kelevrablondie/3DPrinting_CADs_visual-ps5-slab/HANDOFF.md

# Handoff: where the last session stopped (2026-11-10)

Read `CLAUDE.md` first, then `CHANGELOG.md`, then this. Sections below "State before that" are history: the
wrap-around design settled their questions (ends, level edges, disc access). Keep them for the reasoning only.

## Latest (2026-11-10): clip strips built, fit tests ready
- **Built:** the south face lip covers the core to x −17.8 (40 mm face stripe, slot through the lip, hidden guide, square
  corners). It replaces the black filler. Slide-in clip strips (proposal below, approved by Mike) are in `cad/wrap.py`,
  and `cad/check_clip_strips.py` passes for all 9 strips.
- **Ready to print first:** `deliverables/fit_tests/` (two coupons + strip-in-offcut), order in `TODO.md`.
- **Decided, not built:** sleeve (plates overhang both ends by the slide distance), see `CLAUDE.md` Removal / sleeve row. Needs Job 1C.
- **Open from the proposal:** hooks rebuilt as parametric solids (item 4), fewer longer strips, the latch's flex arm,
  a chamfer under the strip's dovetail shoulder (it needs supports now). One end stop sits ~2 mm from the z 164 seam (target ≥3).
  The floor grille still skips holes by the old shelf bboxes (`SHELVES`), not the rails.
- **Next:** stepped seam, sleeve, port cut-outs, then the printable set.

### Clip strips: proposal shown to Mike (approved 2026-11-10; items 1–3 and 6 built)
1. Dovetail channel on the plate's inner floor (part of the tile).
2. Solid end stop on the side that takes the pull when the plate slides off, so removal load goes into plastic, not the latch.
3. Thumb latch at the open end: a flex tab snaps over a ledge; press it and slide the strip out, no tools.
4. Hooks rebuilt as clean parametric solids from our cross-sections (`analysis/section*.py`), same 18 positions; fewer, longer strips where hooks line up (Claude's call).
5. ASA, printed upright, layers along the hook shafts; the tab bends across layers (Claude's call).
6. Fit gate: coupons plus one strip in a channel on a plate offcut, test-locked before any full plate.
Open risk: the stock plate flexes when you lift a corner, ours is a stiff tray. If the latches won't release with a slide alone, the release moves into the strip.

## State before that (2026-11-02)
Still mid-design on the plate edges, west/east ends and disc access. **Nothing is approved to build yet**: Mike must approve a written description first. Branch `handoff-end-panels` was merged into `main` and deleted.

## Decided 2026-11-02 (recorded in `CLAUDE.md`)
1. **Ends: option D.** Mike likes the BoxPlates look: no separate mesh panels; vent slots in the plates' own end walls, wrapping the corners from the fan grille. Merge his ideas with our design for **FDM / DIY**, not injection moulding: our own pattern (not his line pattern), printable without supports in the face-down tile orientation, ASA wall thickness.
2. **Clips: slide-in, replaceable strips** in channels on the plate, no glue. Replaces glued shelves + 0.8 mm pockets.
3. **Seam: diagonal + stepped**, near z≈158, must clear the clip strips.
4. Heat test: optional, "nice to test afterwards".
5. Duplicate `Ps5 *.stl` downloads deleted (all six matched tracked files byte-for-byte past the header).

## Next questions for Mike (one at a time, brainstorming skill)
1. End wall height/profile: level edge vs following the slanted skirt, and whether the slots run the full end or only near the fan (west).
2. Slot style for FDM: e.g. hex holes continuing the grille vs our own slot pattern.
3. Disc access "swoop" (item 4 below) still unresolved.
4. Clip-strip retention: friction fit, snap detent, or a screw/stop at the channel end.

## What Mike asked for (his words, in order)
1. On the end walls added this session: "not what I had in mind". The sides should be "more consistant with the 'hide' language".
2. "additional pannels, that are slants to the new actual side plates and they are meshed, to prevent blocked airflow".
3. The slants should be "visualy level and not repeat the curve of the core".
4. Disc access: "an integrated cutout" in the actual panel, "almost like the original plate does this... the pannel basically swoops in, having a litlle edge lip". Reference: `sources/reference-images/style_reference_render_10.webp`.
5. Compass directions, console horizontal and facing you, disc drive at the bottom right: upper panel **north**, under panel **south**, mesh panels **west and east** ("where the vertical stand and empty space was on the original").
6. "level edges on the x axis throughout the 'face' of the console and it's back. where it blocks airflow, insert the vents."

## Claude's mapping and findings (not yet confirmed by Mike)
- North = flat plate, south = disc plate, west = fan end (z≈380), east = drive end (z≈0).
- Level edge position is limited by the core's widest point plus the 4 mm reveal, using `slab.py`'s tape values:
  - Face: north x=43.7, south x=-39.3, so 15.5 mm deep.
  - Back: north x=46.2, south x=-41.8, so 13 mm deep.
- These edges are shallower than today's slanted skirts in most places and never deeper, leaving up to 21.5 mm open. So vents on the face and back may not be needed, though airflow is untested. The core's curve stays visible in that open band.
- The drive reaches x≈-50.8, past the level edge, so the swoop must drop to near the south plate over z≈0–165. It is only a rough sketch in the mockup. The drive area isn't clearly visible in render 10, so check the stock plate scan too.
- Plates of 424–434 mm should still fit in two tiles on the 256 mm bed, but this is not checked against the shelves or seam.
- Separate mesh panels need their own mounting. Not discussed yet.

## Conflicts to clear with Mike when the design is written up
These `CLAUDE.md` decisions change if this goes ahead: "Edges" (slanted reveal, core-following skirts) and "Drive" (notch).

## Rejected but still in the code
The semi-open walls are still in `cad/slab.py` (`END_FLAT`, `END_DISC`, `end_wall_cut`, the wall zone in `plate()`), which `wrap.py` imports for its constants. Their scripts and renders moved to `archive/` (2026-11-10).

## How to resume
1. The process in use is the `superpowers:brainstorming` skill. Mike accepted its browser mockups. The questions continue one at a time, and a written description needs his approval before any build.
2. The old mockup server dies with the session. To reopen it, run the skill's `scripts/start-server.sh --project-dir <scratchpad> --open`, then copy `docs/mockups/end_panels_screen.html` into the new `screen_dir`. To change the drawings, edit and run `python3 -I docs/mockups/end_panels_mockup.py <out.html>`.
3. Use cadgen as `cadgen +0.8.4`, the installed version.

## Side items
- Job 1B: the 2026-11-09 research makes 114 the working spacing; only a fan-end confirmation is left. Rear ports (X-ray, Job 1D): notches were drafted and then dropped (2026-11-10). The stripe's disc-side edge moved to −25.5 instead, so plugs clear it; one HDMI reading checks the clearance. (The face side changed again the same day, see Latest.) Job 1C is on hold.
- That model's creator and licence are still unconfirmed, because Cloudflare blocked curl and Mike saved the files rather than the page.

## Video reference: devynPC "BoxPlates" (reviewed 2026-11-02)
Devyn Johnston, "I fixed the PS5 and now YOU can too", https://youtu.be/dNhaeyO8Zh0 (6:03, 31 May 2025). Same maker as the "devynPC-style" shelves. Commercial, injection-moulded flat plates. **No dimensions given.** His prototype was for a PS5 **Pro Digital**, so nothing is fit-verified for our original Disc Edition. Borrow ideas only; his line-pattern look is his design, so don't copy it. Times are transcript times; frame-only observations are approximate.

1. **Seam (open item 2):** his printed prototype is two shells joined by a **diagonal, stepped seam**, not a straight cut, and has hook pads on the floor. It's an option for our z≈158 seam: stiffer and self-aligning.
2. **Clips (4:21–5:01):** separate **slide-in, replaceable** clip strips in PETG (thick walls, dense infill, internal supports) slot into a channel on the plate's inner wall. Ours are glued. Slide-in would remove the glue-and-align step and allow a reprint of one broken clip. This doesn't reopen the "Mounting" decision; ask Mike before changing it.
3. **Airflow (3:01–3:42):** fine parallel slots over the fan carry on down the front lip, **wrap the corners** and run along the sides. This is a possible 4th answer to the west/east end question above: slots cut through the plate's own end walls instead of separate mesh panels, so no extra mounting is needed.
4. **Stock plates block the side intake (3:16–3:30)** and route air round the top and front. Sony's plastic rails round the fan keep the plate off it, so leave clearance over those rails. This supports grilles on both plates.
5. **Thermals (3:44–4:19):** 2 h God of War Ragnarök with stock plates vs 2 h with BoxPlates on a PS5 Pro, filmed with FLIR: same at the centre, cooler overall and at the rear vent. Not rigorous; weak evidence that open sides are safe.
6. **Disc models (2:35–2:39)** need a new bottom plate with a hidden disc slot, which relates to Mike's "swoop" disc access. Not shown in detail.
7. **Geometry (1:47–2:10):** he used a 3D scan, then removed the tilt and straightened the angles; "way more iterations than I expected". Expect several test prints (see Job 1B and the coupons).

## Video reference 2: devynPC "I fixed the PS5 Pro" (reviewed 2026-11-02)
Devyn Johnston, https://youtu.be/yilU2dU2YgA (4:50, 20 Jan 2025). This is the first prototype, made before BoxPlates. The console is a **PS5 Pro** (four plates, two per side), so again nothing is fit-verified for our Disc Edition. **No dimensions, materials or print settings are given.** Times are caption times; frame-only observations are approximate.

1. **Alignment is the main risk (2:49–3:07):** getting each plate's tilt and angle right "took the most trial and error". **1–2 mm off** and the plates collide, clips miss, or the plate visibly isn't level. That supports Job 1B, the coupons, and a cheap partial test print before a full plate.
2. **Check level with a spirit level (~3:20, frame):** he put a spirit level on the printed top plate. Add a spirit-level check to our test fit.
3. **Clips rebuilt as clean CAD (~2:40–2:50, frames):** he aligned the scanned clips, then modelled clean solid clips (ribbed hooks) on top of them instead of using the scan mesh. Our shelves come from scan meshes (`analysis/shelves.py`). When we design the slide-in strips, rebuild the hooks as parametric solids from our clip cross-sections (`analysis/section*.py`).
4. **The first prototype had fixed clips; BoxPlates has slide-in strips.** That's an inference that he moved away from fixed clips, but the video doesn't give a reason.
5. **Vents only where the stock plates left openings (3:24–3:34):** fan grille plus holes on the front and sides. The CAD frames (~3:40) show the hole pattern continuing over the plate's end wall and lip, which is option D. His pattern is an Xbox One S style grid of round holes with a chamfered look, taken from Microsoft's design, so again don't copy it. Our hex grille is our own.
6. **Front lip lowered to hide the curve (0:57–1:03):** the plate lip comes down over the core's curve, leaving the glossy middle strip and its ports open. That matches our "hide" language and the level face and back edges in "What Mike asked for", item 6.
7. **Plate as a shallow tray (~3:30, frame):** a section view shows a floor with low walls and a step partway along. That may be an early version of the stepped seam, but it can't be confirmed from the frame.

## Wrap-around mockup (2026-11-02)
Mike pointed to the 1:05 sketch in video 2: plates as level, constant-height lips with a constant black stripe between them, and the same treatment on the west and east ends. The colour inserts move to the **face**. Drawing: `docs/mockups/wrap_views.png`, made with `python3 -I docs/mockups/wrap_mockup.py <out.png>`.
- Stripe 40 mm, centred on the core (x −17.8…22.2), which is the core's narrowest front width. Each lip comes out at 39.5 mm, so the front reads as thirds. **Superseded 2026-11-10:** stripe x −25.5…22.2 (~48 mm), lips 39.5 / ~32, see `CLAUDE.md` Wrap row.
- Face: vents on both lips at the fan (W) end. The south lip runs level over the drive (z 0…135), and the drive sits behind it with a disc slot hole like the stock faceplate (Mike, 2026-11-02; replaces the swoop). In the core proxy the drive is x −50.8…−17.8, inside the lip, and flush with the core face at y 127.5. The colour inserts sit on the north lip at the E end.
- Back: the lips cover the exhaust, so they are vented end to end. **Port positions are not measured**, and the lips need cut-outs there.
- Ends: both end walls are fully vented (option D), with the same stripe.
- **Depth problem:** a lip that hides the core's curve sits in front of the core face. The core proxy is ±127.5 deep for z 0…200 and tapers to ±121 at the fan end, so the plates grow to about 261 mm deep (0.5 clearance + 2.5 wall per side). That doesn't fit the 256 mm bed in any orientation. **Mike chose separate lip strips** welded to the plate edge (recorded in `CLAUDE.md`). Port positions: TODO.md Job 1D.

## Disc slot, taken from the stock disc-plate scan (2026-11-02)
Measured in `sources/rhys34512-printables-973426/disk-panel.stl` (front-facing surfaces plus sections at z′ 56/96/166), in the console frame:
- **Length:** z′ 22.5…145 (≈122.5 mm, for a 120 mm disc). The drive proxy stops at z 135, so the proxy is about 10 mm short.
- **Width:** 6.0–6.7 mm. It follows the plate's ~2 mm twist, and the straight path common to the whole length is x′ −25.5…−21. The mockup uses x′ −25.5…−20.5.
- **Depth:** the stock slot is not a hole in the face. It's a gap at y′ ≈ 111–113, about 16 mm behind the core face line (127.5), between the end of the plate's angled lower wall and a hollow **box-section edge** (x′ −20…−8) above it.
- **Consequences for the lip strip:** only ~2.7 mm of lip is left between the slot and the stripe edge (−17.8). Copy the stock idea: back that narrow bridge with a box or L section, and guide the disc from the lip slot (y′ ≈ 128–130) back to the drive entry at y′ ≈ 111 with a short tunnel or funnel. The mockup shows only the face opening.

## Back-lip ventilation (2026-11-02)
Mike: the back edges must not obstruct the exhaust, so use bigger openings or a different pattern.
- The back lips cover the core's rear exhaust where the core is wider than the 40 mm stripe: 20 mm per side at the drive end, tapering to 2.5 mm at the fan end. That's about 8,550 of about 23,750 mm², or **~36 % of the rear exhaust face**.
- The round 3.4 mm holes at 5 mm pitch are 42 % open, which leaves **~79 %** of the stock exhaust area overall. A **6 mm hex honeycomb with 1.2 mm webs** is 69 % open, which gives **~89 %**. It's printable: three perimeters at 0.4 mm, holes vertical with the strip face-down. Chosen and drawn in `wrap_views.png`.
- Further lever if the heat test says so: let the back lip stand off the core by a few mm to form a plenum, so air can spread to the open stripe. The lip strips aren't limited by bed depth. Not drawn.
- These are area estimates, not a flow test. Airflow is unverified until the optional heat test.

**Update:** Mike chose the honeycomb for every vent, fan grilles included (2026-11-02). The 2D mockup `wrap_views.png` is final at this stage, and the next step is a 3D draft.

## 3D draft (2026-11-02)
`cad/wrap.py` → `wrap_horizontal` (386 × 261 × 131 mm, 29 parts, ~50 s cold build). Its parts: floor trays with a honeycomb grille, separate face, back and end lip strips (honeycomb vents, the disc slot in the south face lip, colour inserts on the north face lip), TPU feet, the core and drive proxies, and the old shelves relabelled `clip_placeholder_*` (since 2026-11-10: real clip strips and a disc guide). Not drawn: stepped seam, port cut-outs.
**Open question for Mike, orientation:** the model comes from the real-plate scans, and the disc slot confirms +Y is the front. Seen from the front with the console lying disc-side down, it puts the **drive end on the left**. Mike described the drive at the bottom **right**, and `wrap_views.png` follows his description. **Resolved (Mike): trust the model.** From the front, the drive end (E) is on the left and the fan end (W) on the right. `wrap_views.png` is flipped to match. `Superpowers Brainstorming.html` is deleted (deprecated). In the viewer, 0.4 mm engravings show only in **solid** display mode (edges); shaded hides them.

## North top treatment (2026-11-02, built in `wrap.py`)
Mike's answers: hidden seam yes; hide the fan grille but keep the honeycomb; generic technical markings named **MONOLITH**; no colour inlay; single grey. Reference: the Xbox One X Cyberpunk 2077 controller (split line, bracketed mono text). Details are in the CLAUDE.md row "North top". Clip footprints in `wrap.py` `SHELVES` are bboxes copied from the shelf STLs (a `shortcut:` comment). Regenerate them once the slide-in strips exist, and re-check the seam window: z 155…170 north, ≤158 disc middle.
