kelevrablondie/3DPrinting_CADs_visual-ps5-slab/analysis/adapter_concept.png

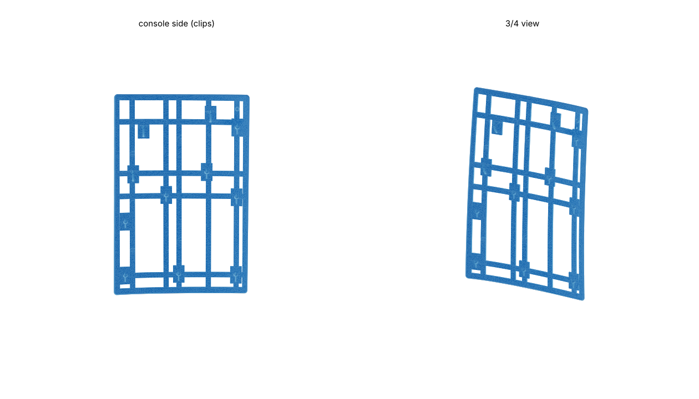
analysis/adapter_concept.png
