kelevrablondie/3DPrinting_CADs_visual-ps5-slab/analysis/clip_map.png

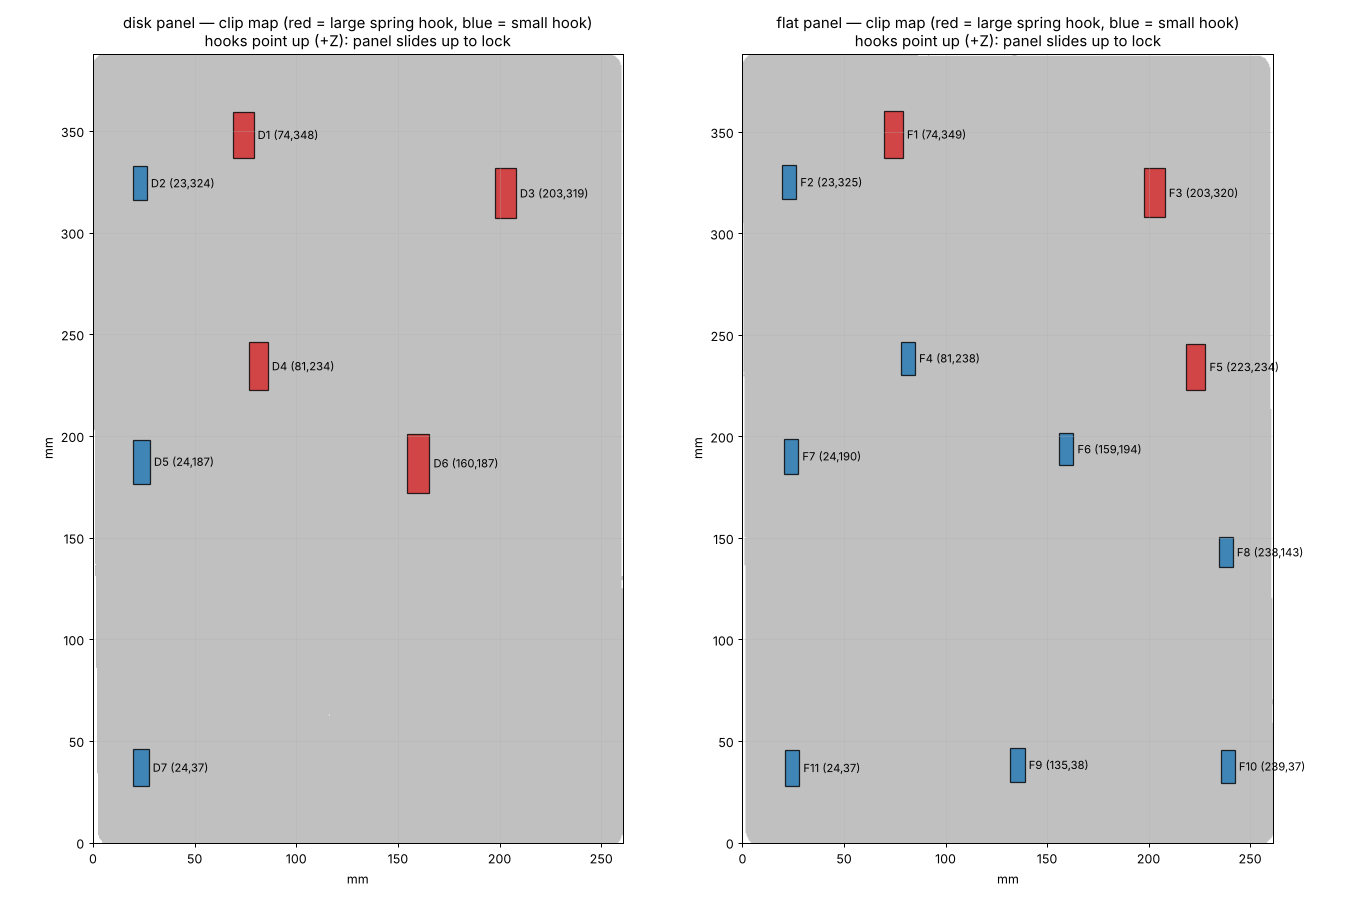
analysis/clip_map.png
