kelevrablondie/3DPrinting_CADs_visual-ps5-slab/analysis/clip_sections.png

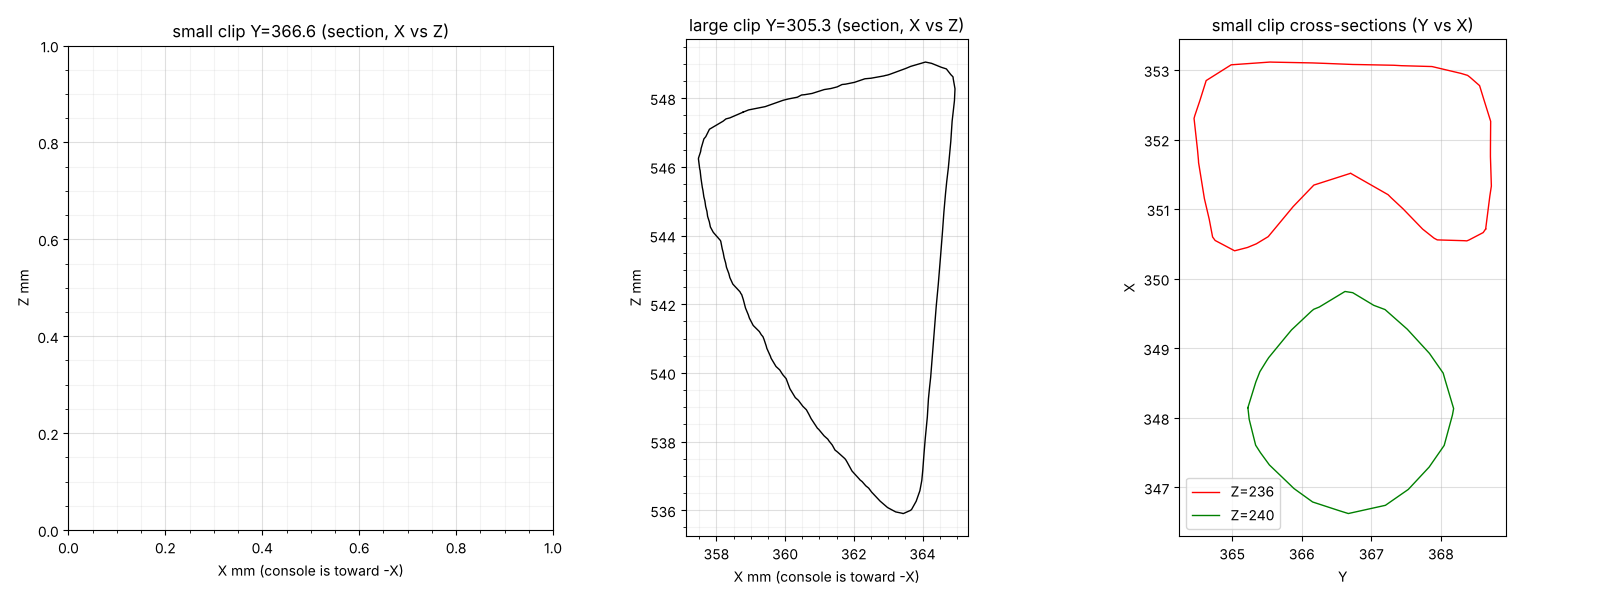
analysis/clip_sections.png
