kelevrablondie/3DPrinting_CADs_visual-ps5-slab/analysis/coupons.png

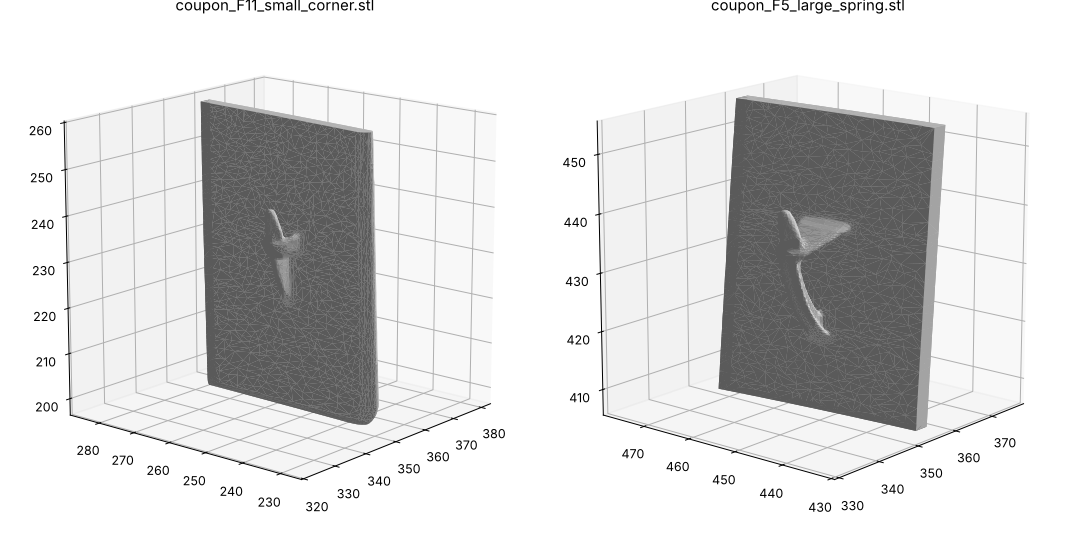
analysis/coupons.png
