kelevrablondie/3DPrinting_CADs_visual-ps5-slab/analysis/disk_inner.png

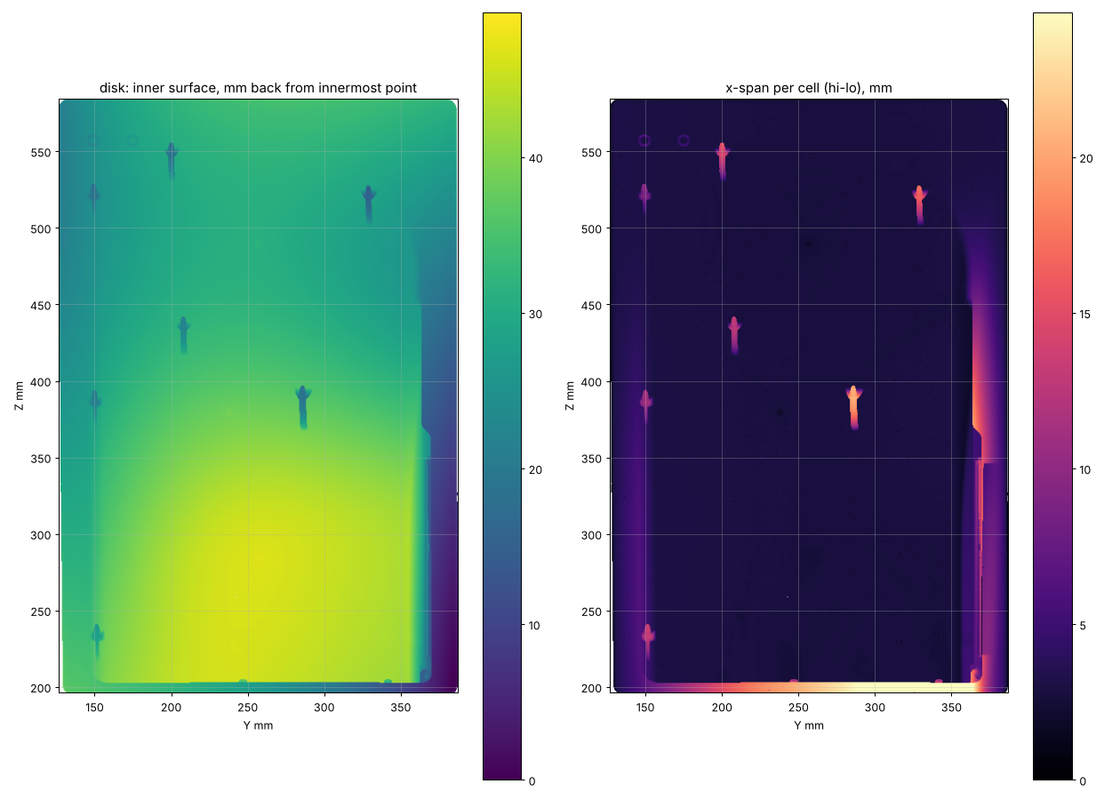
analysis/disk_inner.png
