kelevrablondie/3DPrinting_CADs_visual-ps5-slab/analysis/disk_sec.png

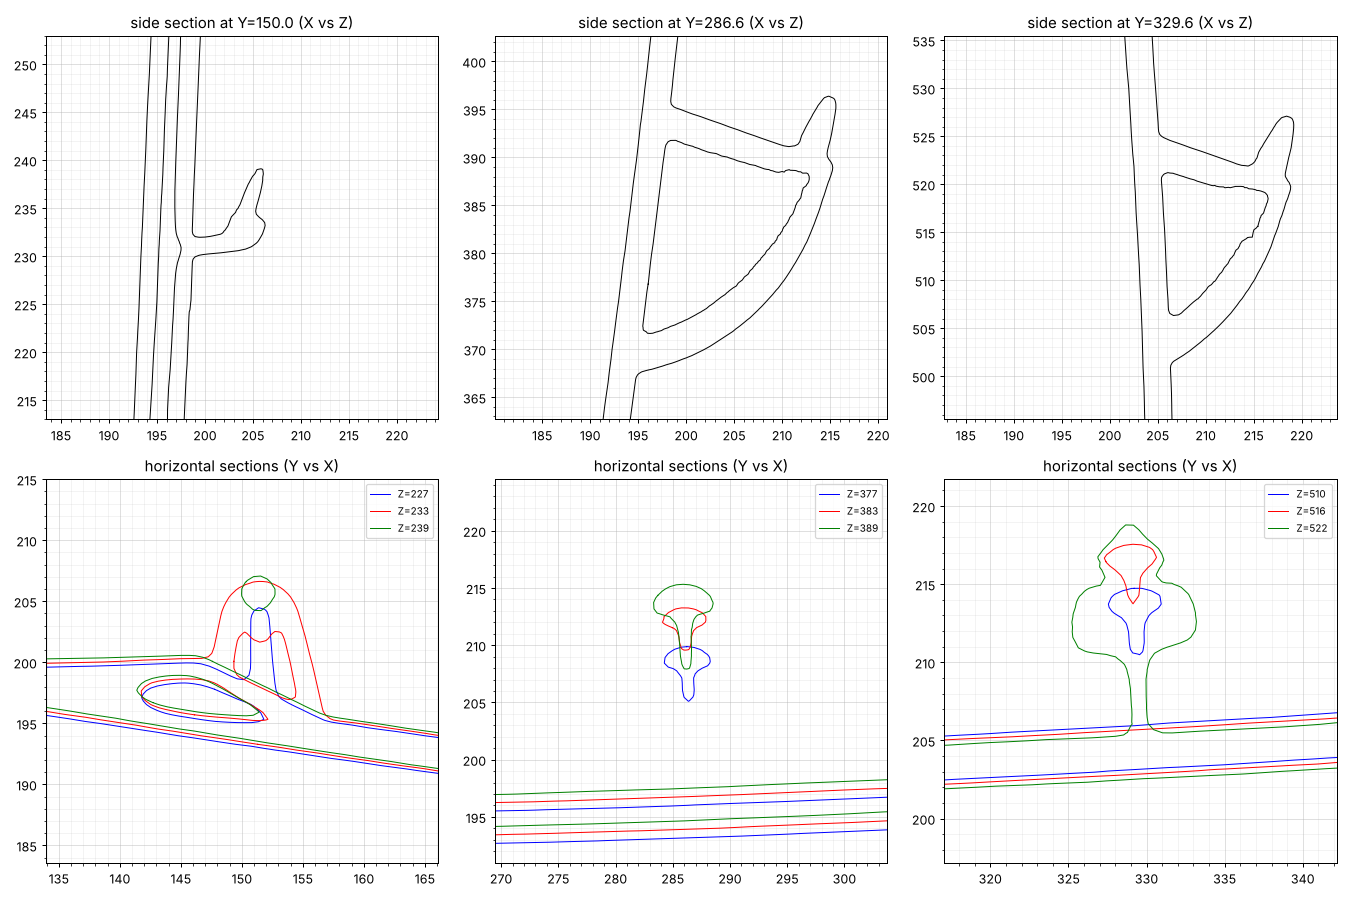
analysis/disk_sec.png
