kelevrablondie/3DPrinting_CADs_visual-ps5-slab/analysis/edge_depth.png

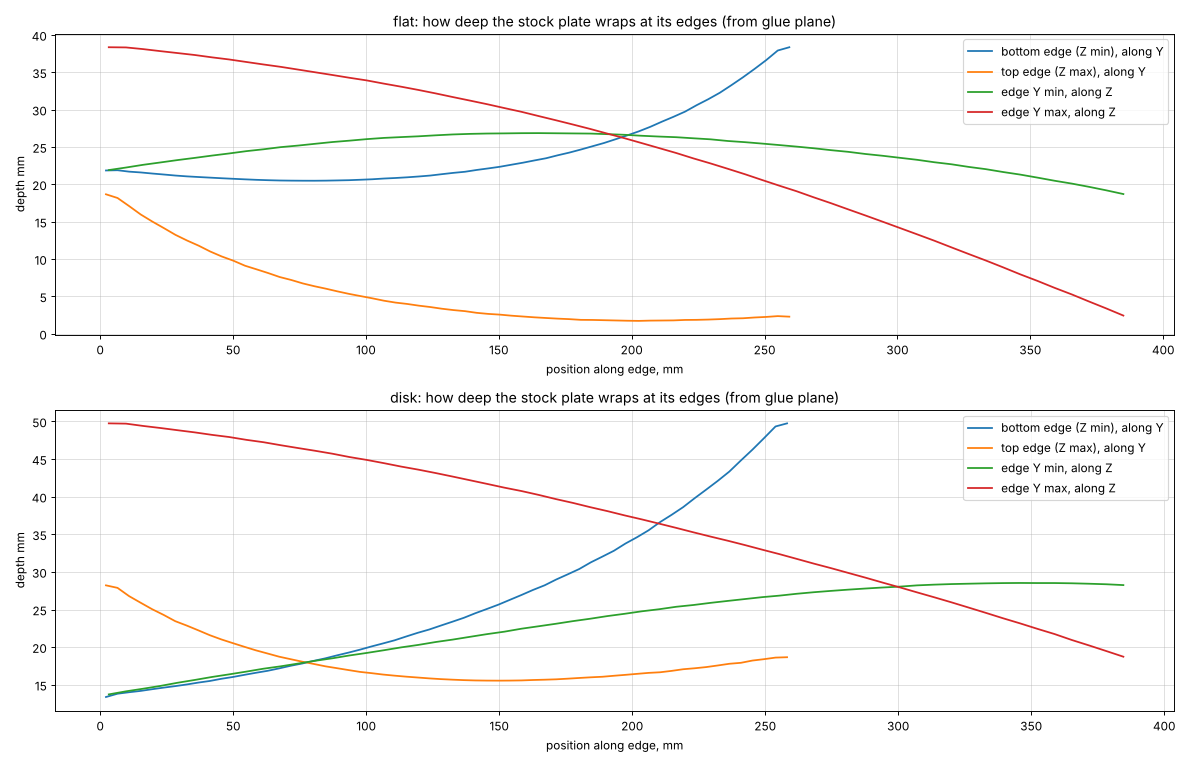
analysis/edge_depth.png
