kelevrablondie/3DPrinting_CADs_visual-ps5-slab/analysis/flat_inner.png

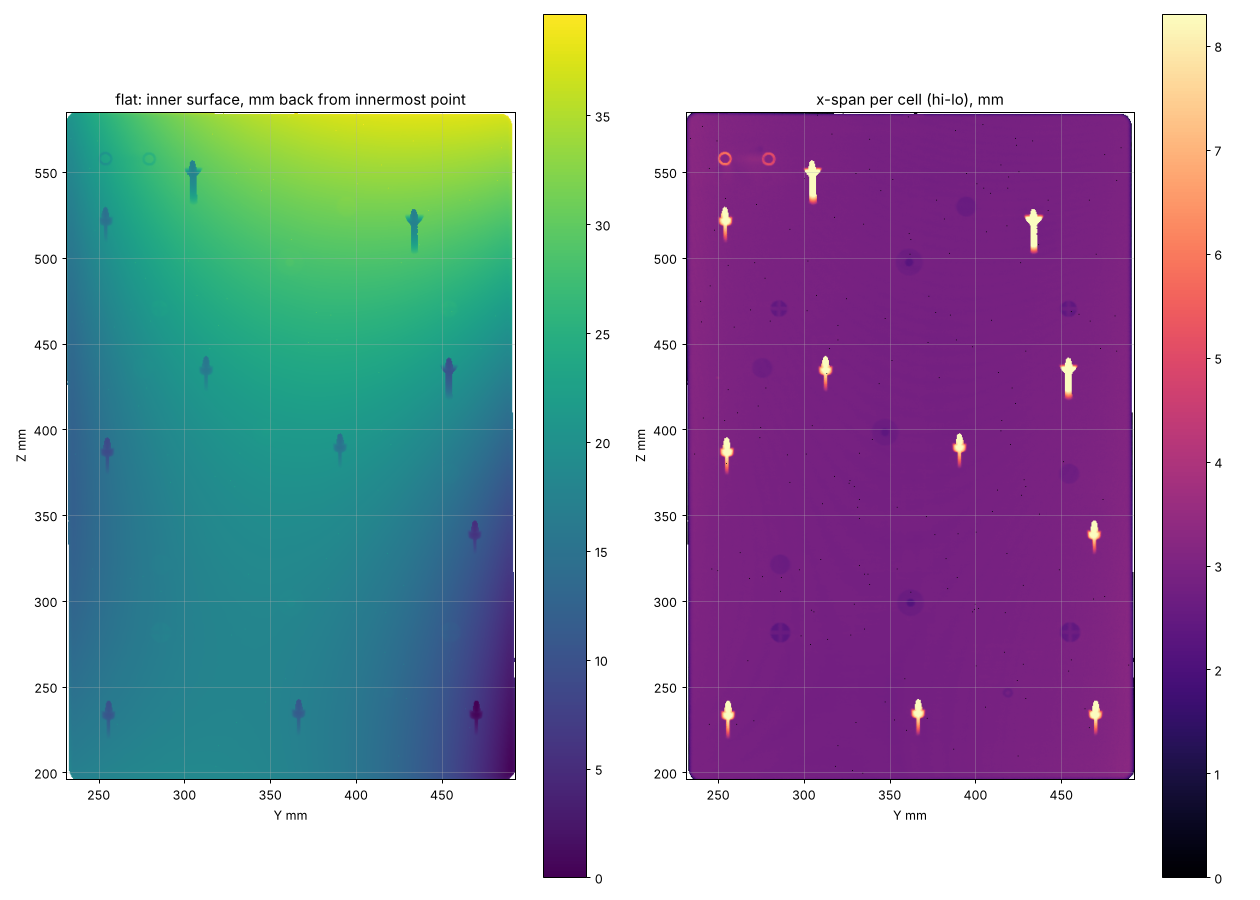
analysis/flat_inner.png
