kelevrablondie/3DPrinting_CADs_visual-ps5-slab/analysis/flat_sec.png

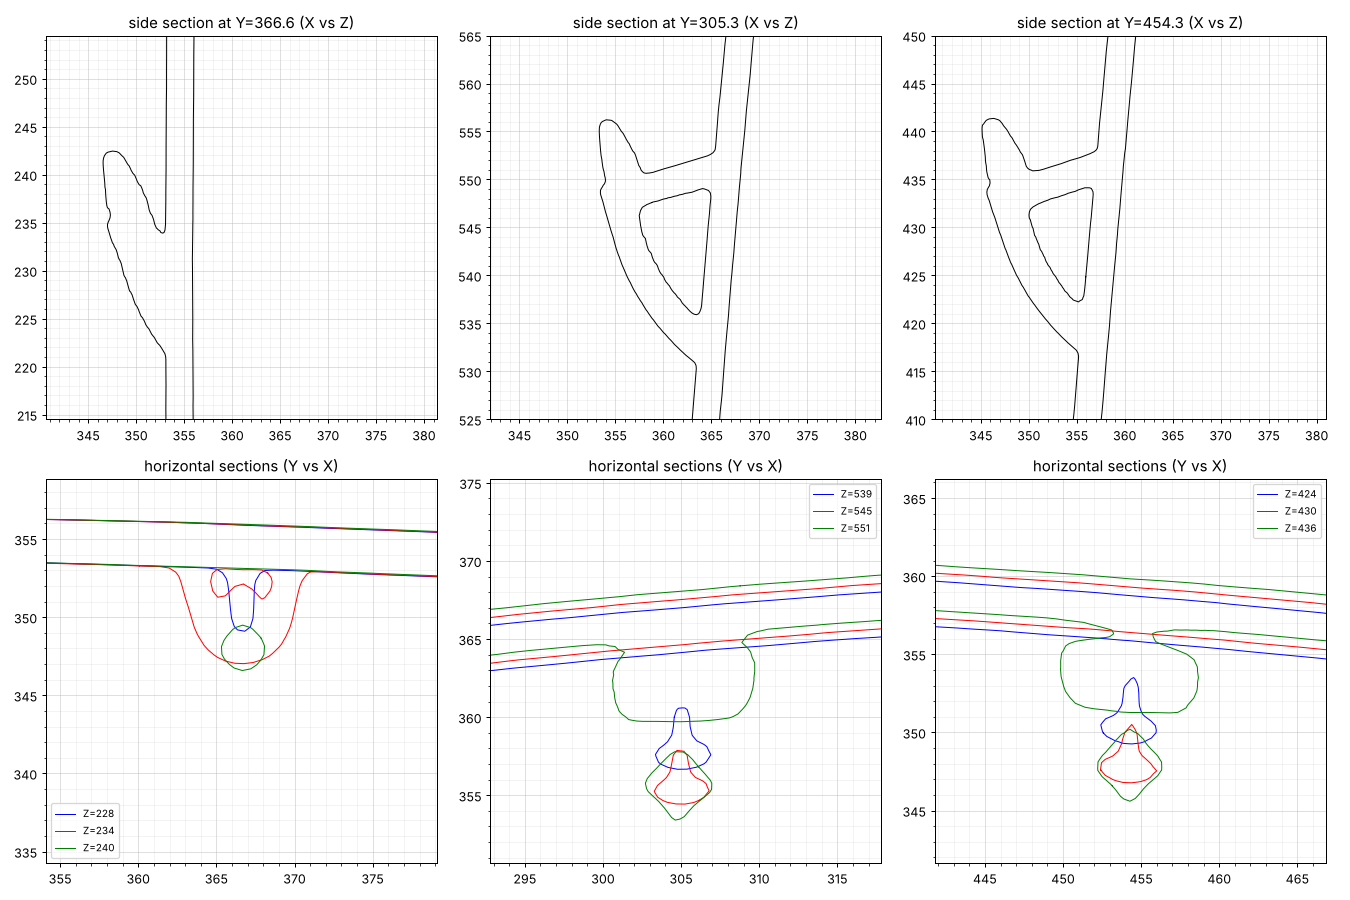
analysis/flat_sec.png
