kelevrablondie/3DPrinting_CADs_visual-ps5-slab/analysis/obj_sections.png

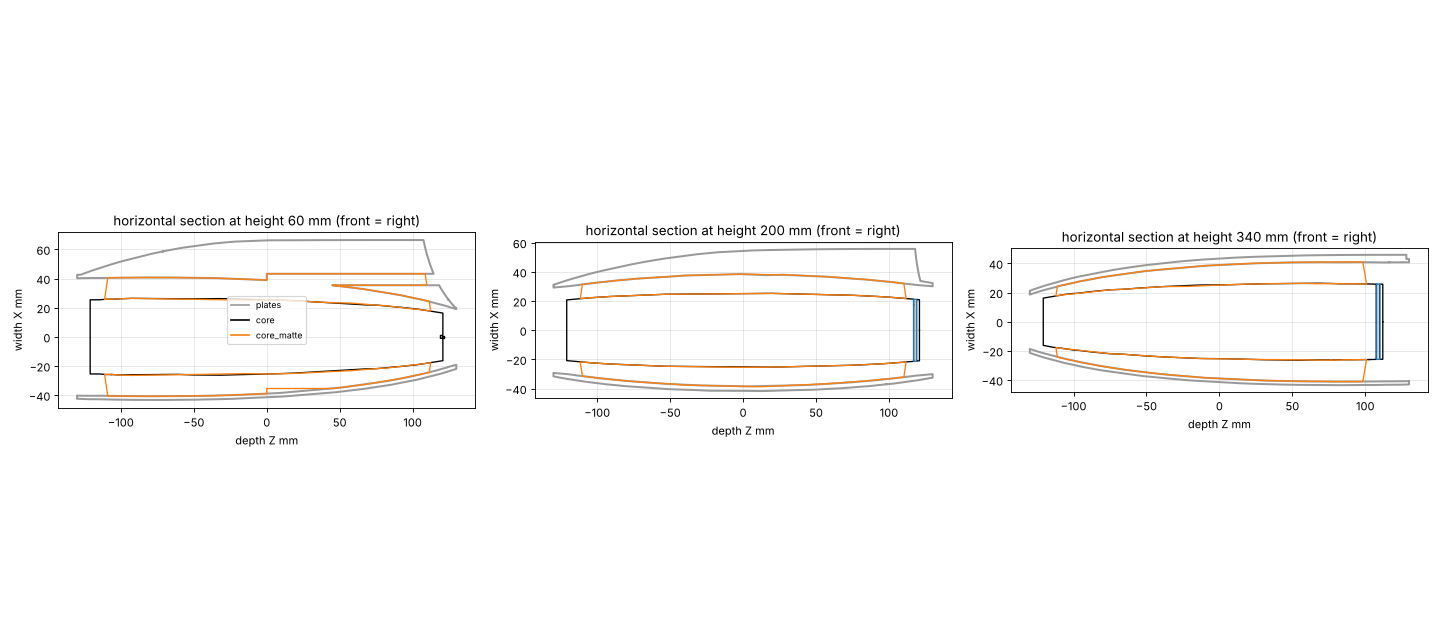
analysis/obj_sections.png
