kelevrablondie/3DPrinting_CADs_visual-ps5-slab/analysis/panel_shape.png

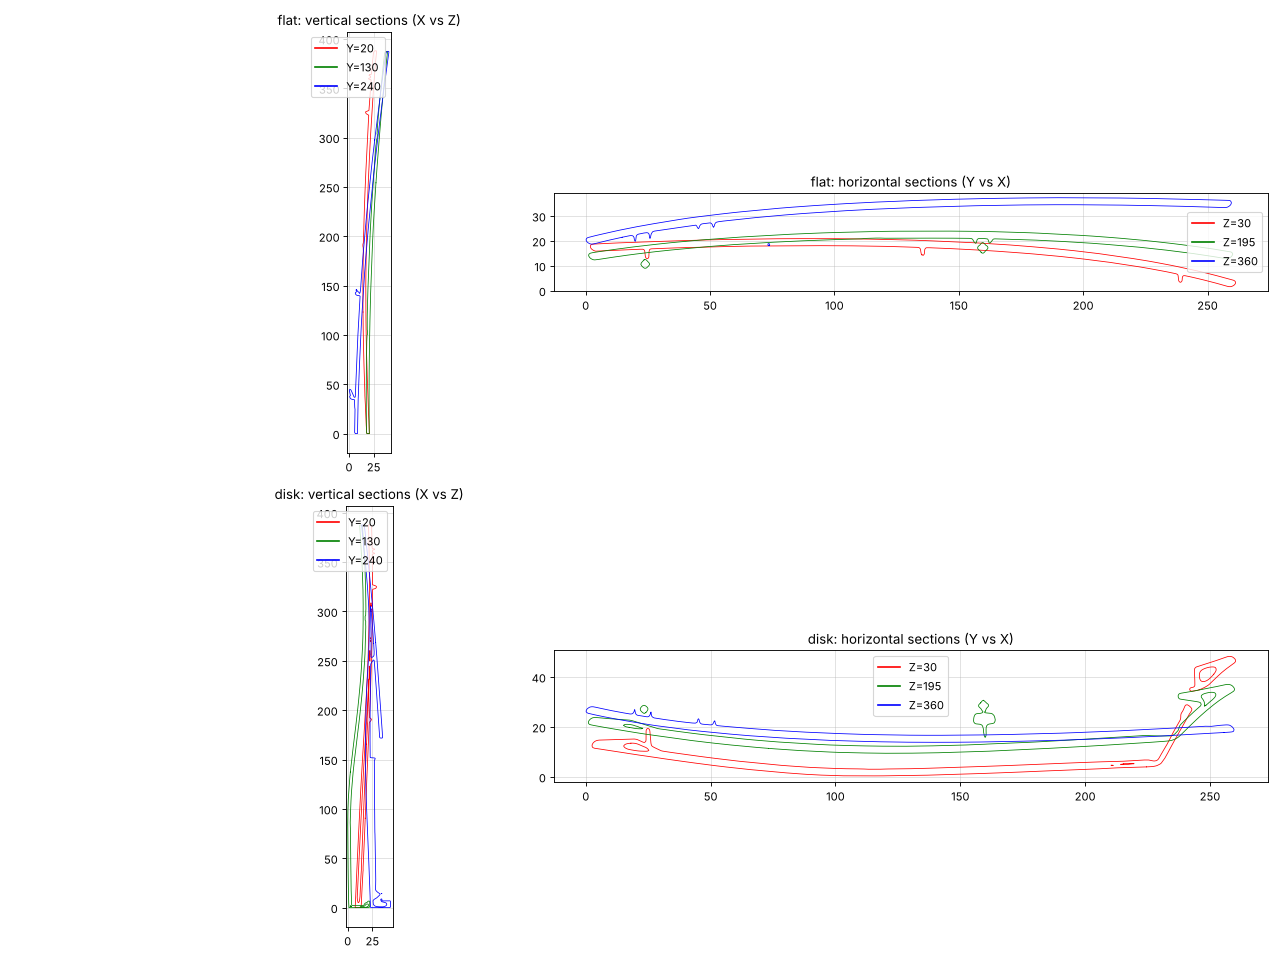
analysis/panel_shape.png
