kelevrablondie/3DPrinting_CADs_visual-ps5-slab/analysis/shelf_detail.png

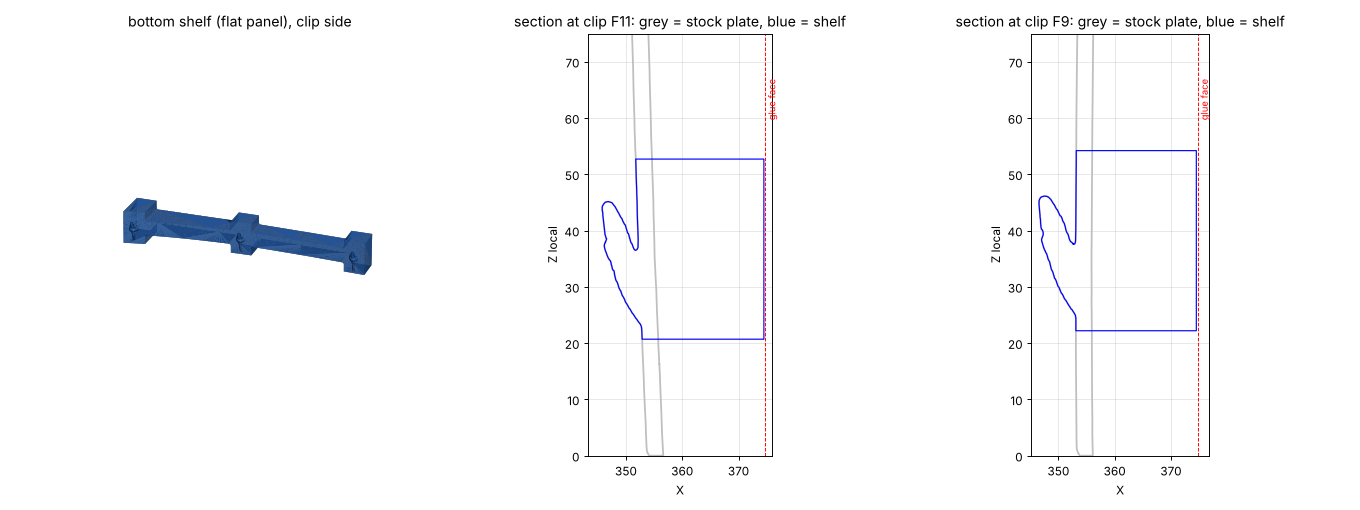
analysis/shelf_detail.png
