kelevrablondie/3DPrinting_CADs_visual-ps5-slab/analysis/shelves_overview.png

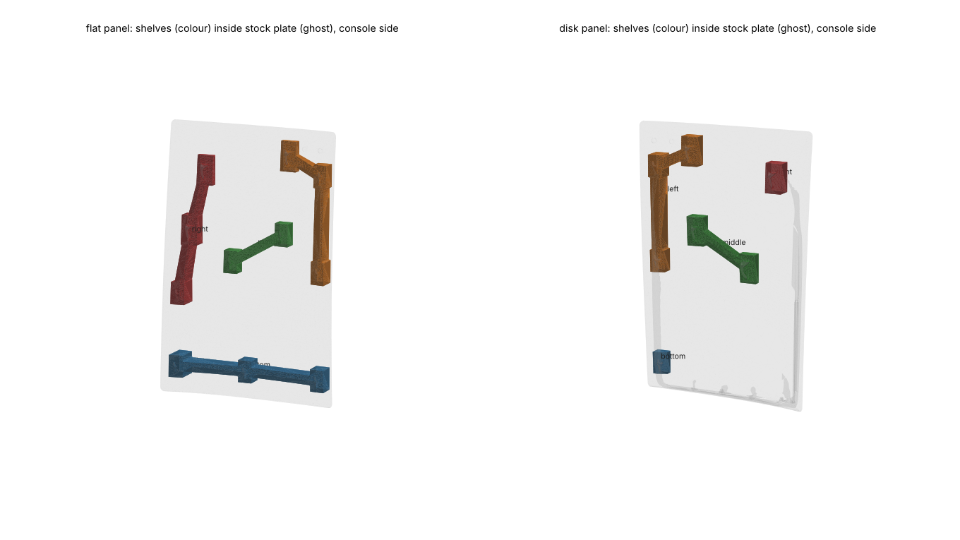
analysis/shelves_overview.png
