kelevrablondie/3DPrinting_CADs_visual-ps5-slab/cad/concept_a.png

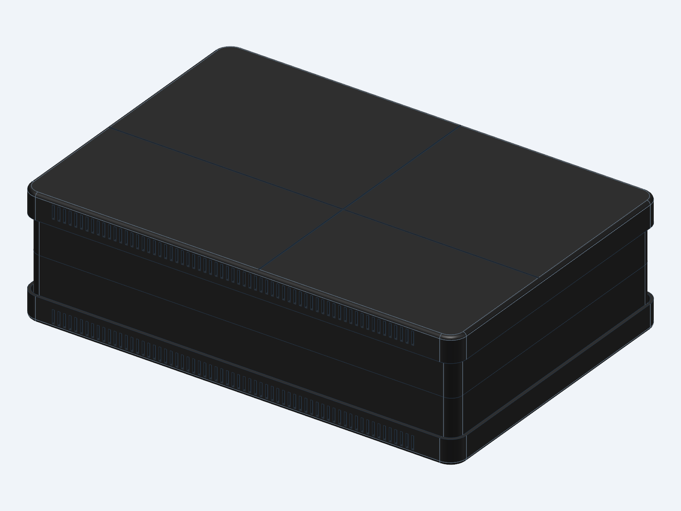
cad/concept_a.png
