kelevrablondie/3DPrinting_CADs_visual-ps5-slab/cad/concept_c.png

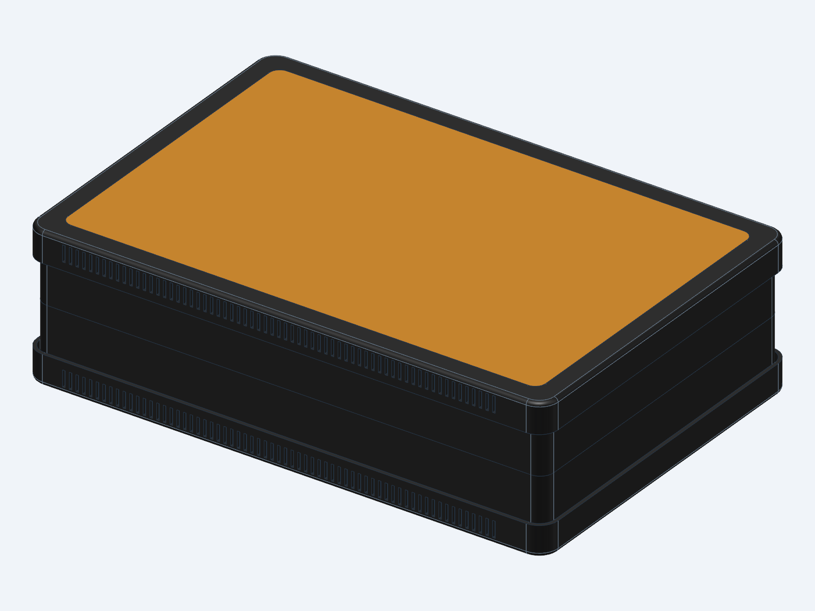
cad/concept_c.png
