kelevrablondie/3DPrinting_CADs_visual-ps5-slab/cad/concept_d_front.png

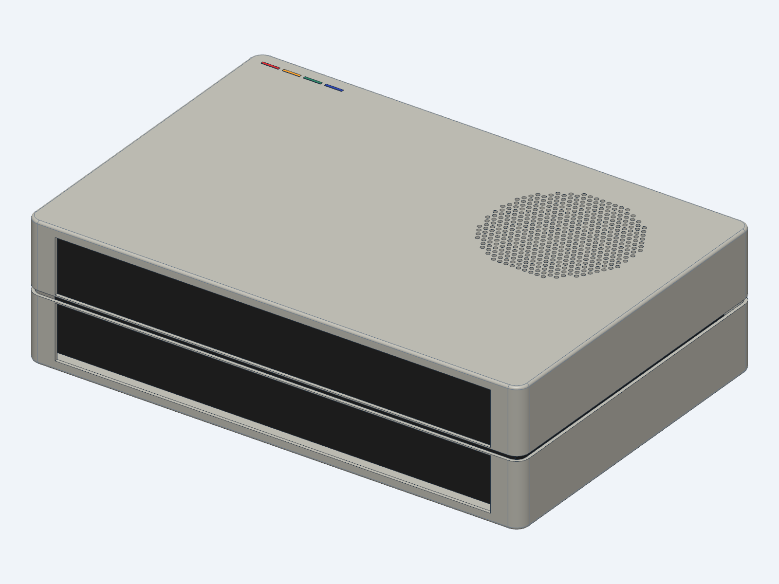
cad/concept_d_front.png
