kelevrablondie/3DPrinting_CADs_visual-ps5-slab/cad/concept_d_rear.png

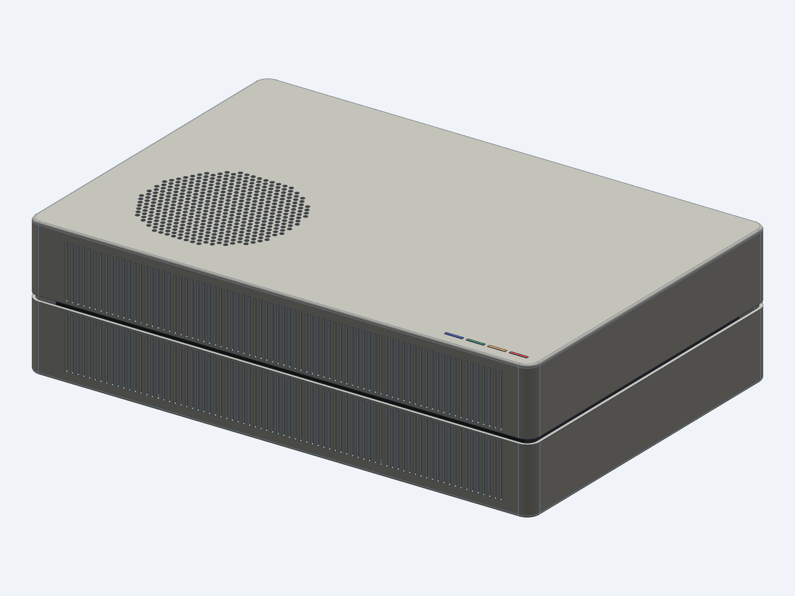
cad/concept_d_rear.png
