kelevrablondie/3DPrinting_CADs_visual-ps5-slab/cad/e_30_20.png

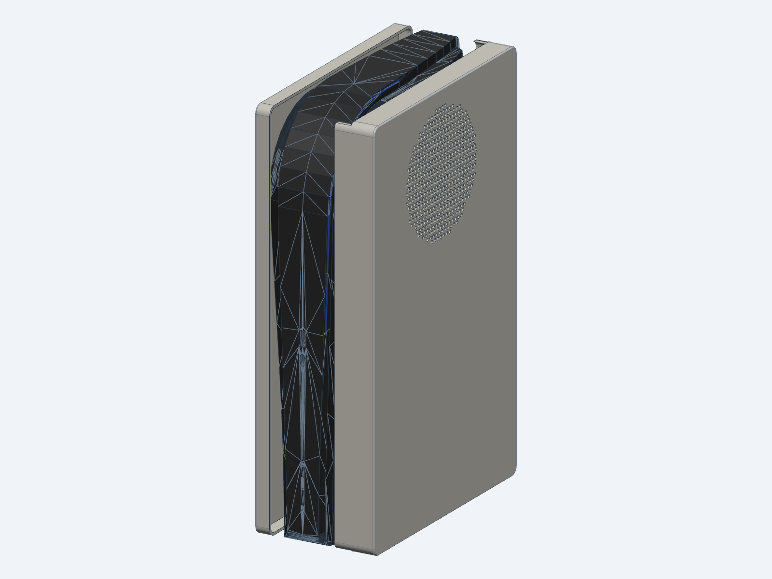
cad/e_30_20.png
