kelevrablondie/3DPrinting_CADs_visual-ps5-slab/cad/e_120_20.png

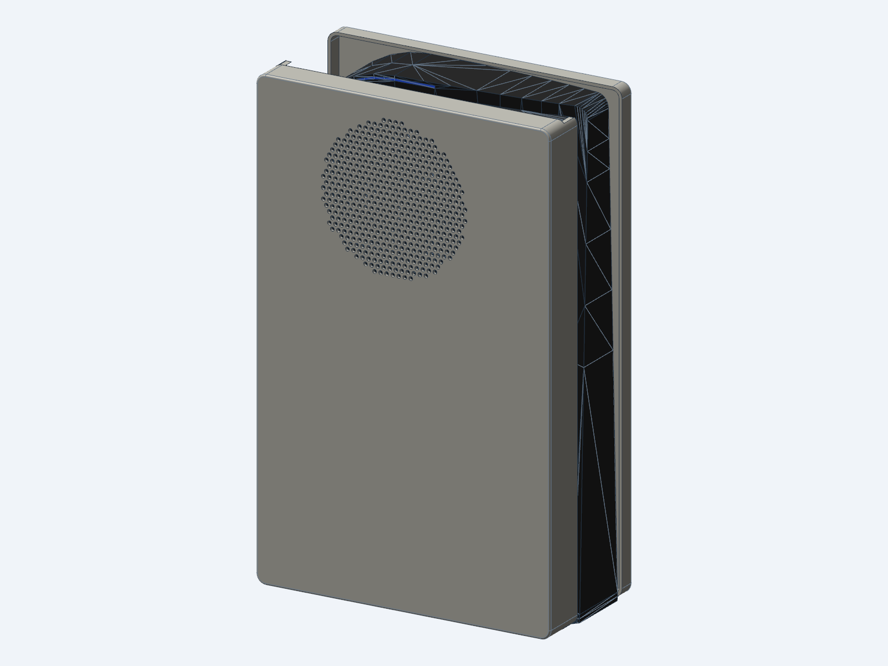
cad/e_120_20.png
