kelevrablondie/3DPrinting_CADs_visual-ps5-slab/cad/e_lie_200_25.png

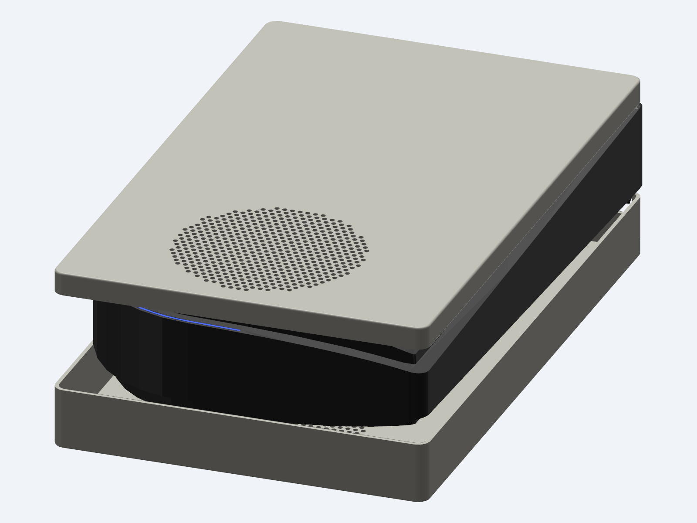
cad/e_lie_200_25.png
