kelevrablondie/3DPrinting_CADs_visual-ps5-slab/cad/e_stand_frontortho.png

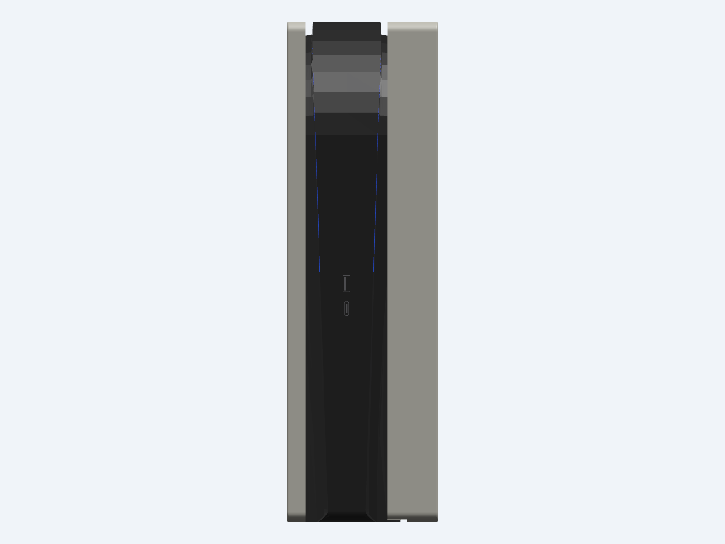
cad/e_stand_frontortho.png
