kelevrablondie/3DPrinting_CADs_visual-ps5-slab/cad/renders/contact.png

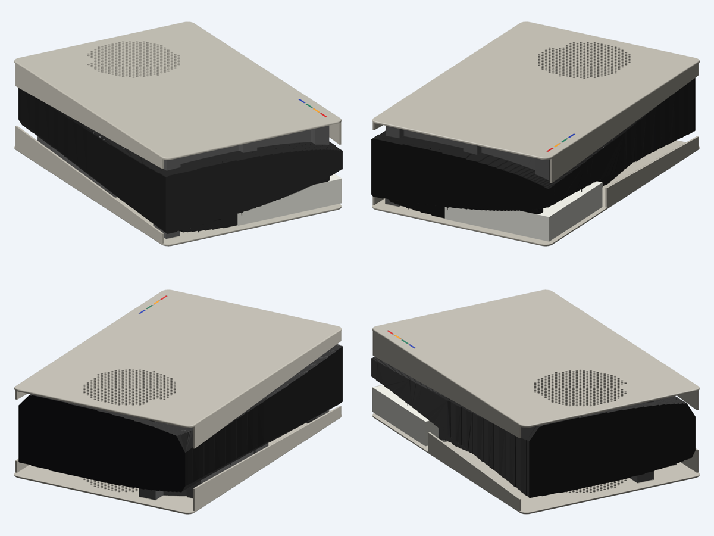
cad/renders/contact.png
