kelevrablondie/3DPrinting_CADs_visual-ps5-slab/cad/renders/ends_left.png

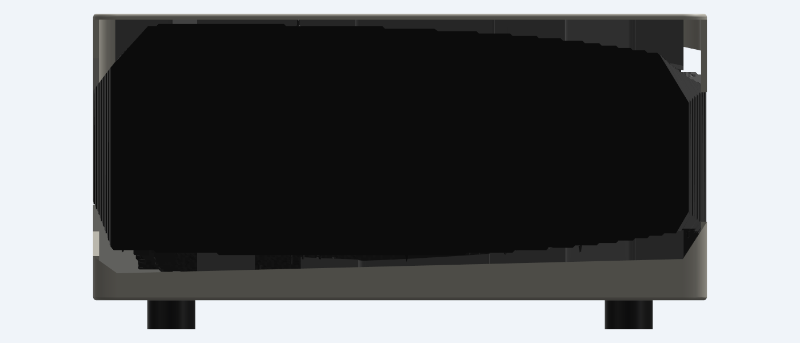
cad/renders/ends_left.png
