kelevrablondie/3DPrinting_CADs_visual-ps5-slab/cad/renders/h_120_22.png

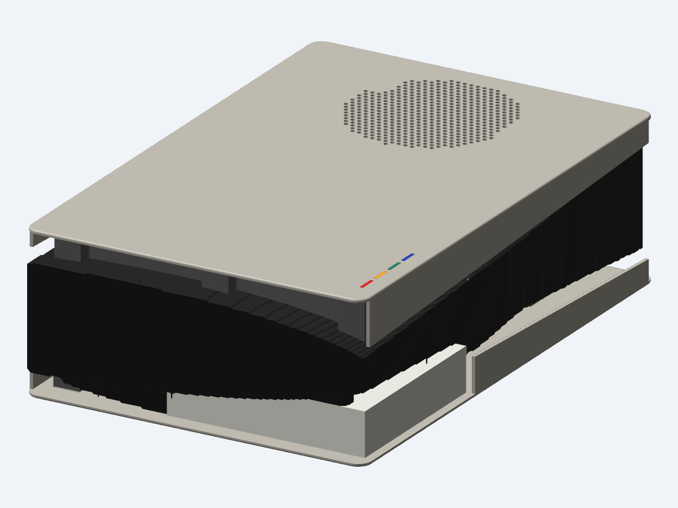
cad/renders/h_120_22.png
