kelevrablondie/3DPrinting_CADs_visual-ps5-slab/cad/renders/h_-60_22.png

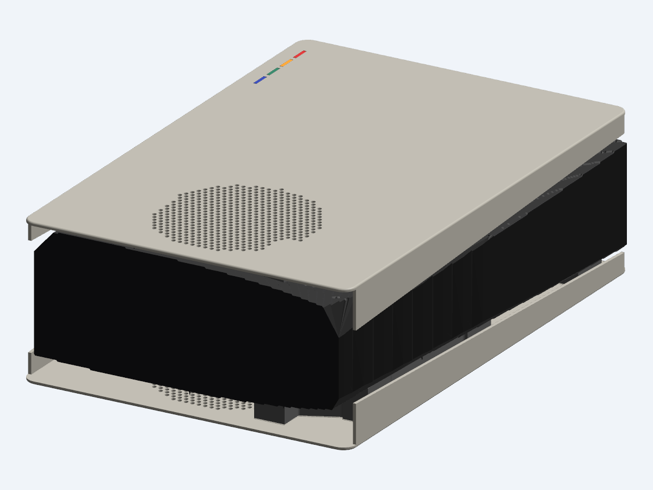
cad/renders/h_-60_22.png
