kelevrablondie/3DPrinting_CADs_visual-ps5-slab/cad/renders/h_front.png

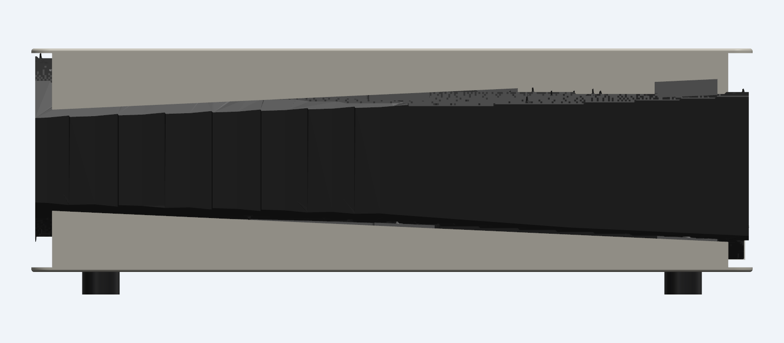
cad/renders/h_front.png
