kelevrablondie/3DPrinting_CADs_visual-ps5-slab/cad/renders/hero_rear.png

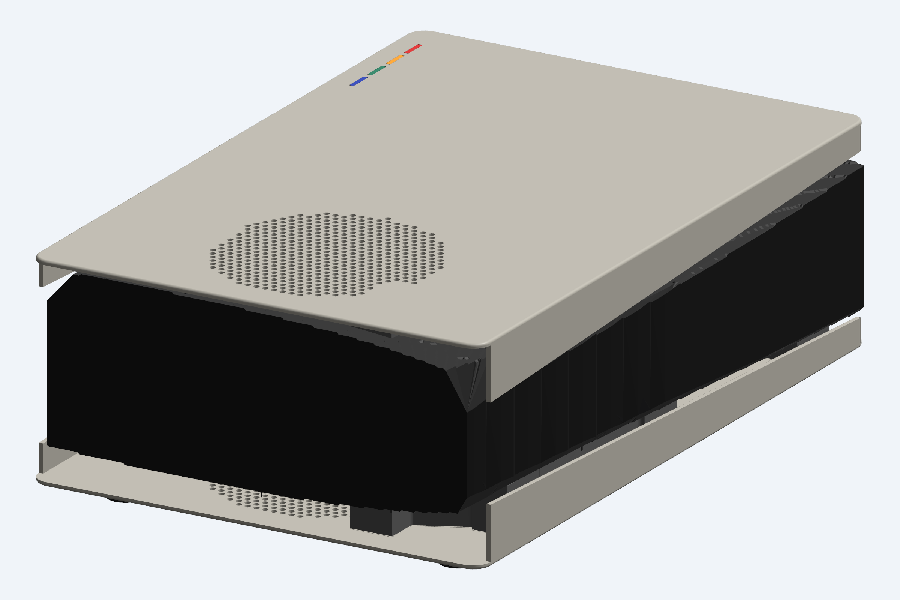
cad/renders/hero_rear.png
