kelevrablondie/3DPrinting_CADs_visual-ps5-slab/cad/renders/inside.png

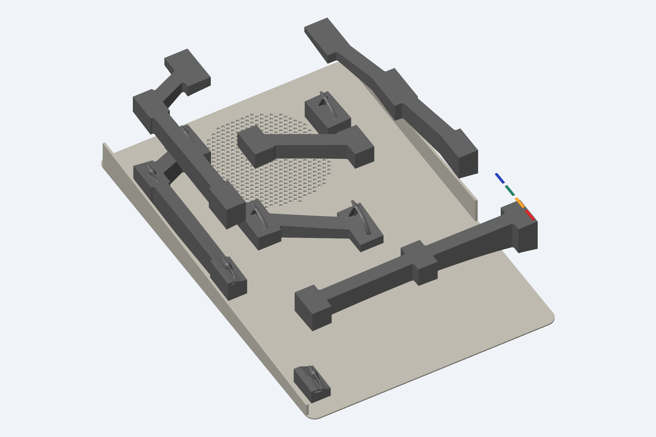
cad/renders/inside.png
