kelevrablondie/3DPrinting_CADs_visual-ps5-slab/cad/renders/ortho.png

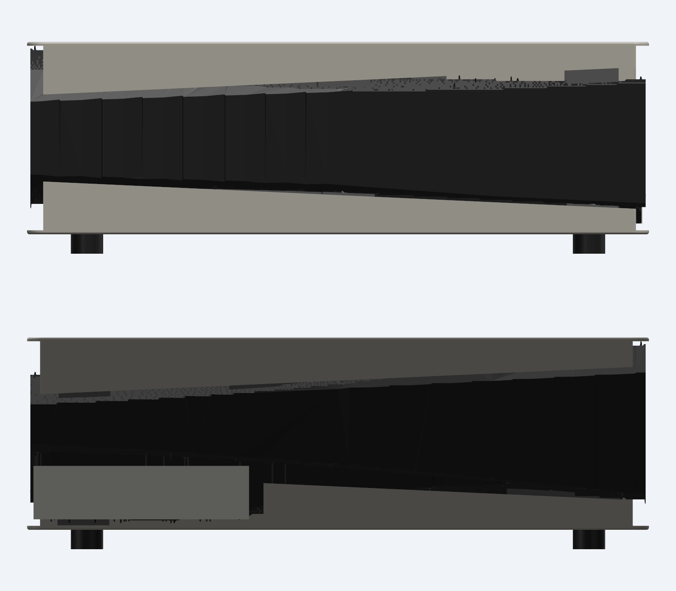
cad/renders/ortho.png
