kelevrablondie/3DPrinting_CADs_visual-ps5-slab/docs/mockups/end_panel_options.png

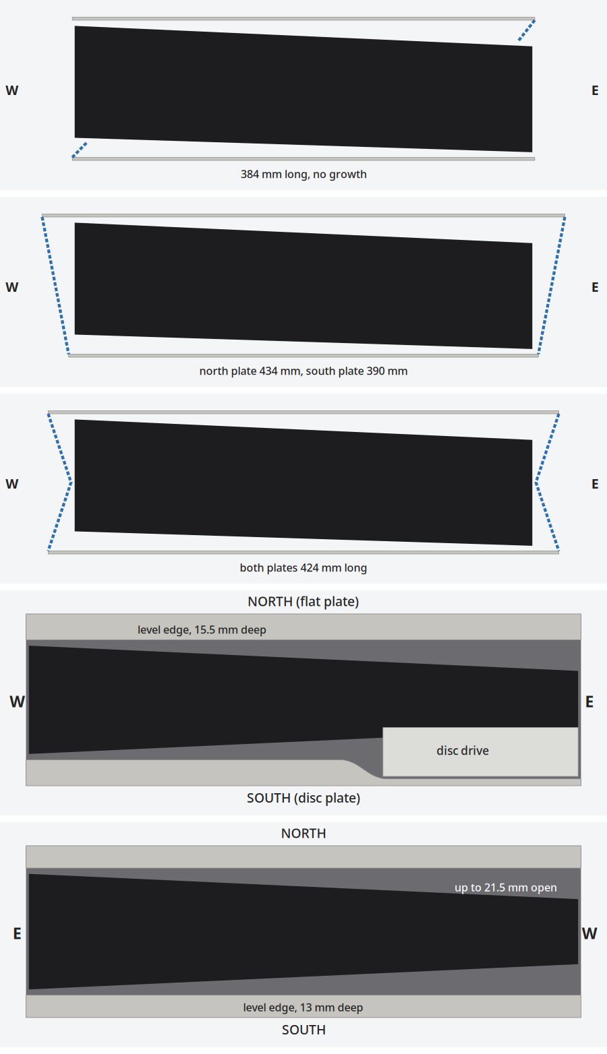
docs/mockups/end_panel_options.png
