kelevrablondie/3DPrinting_CADs_visual-ps5-slab/docs/mockups/explode/explode_overall.png

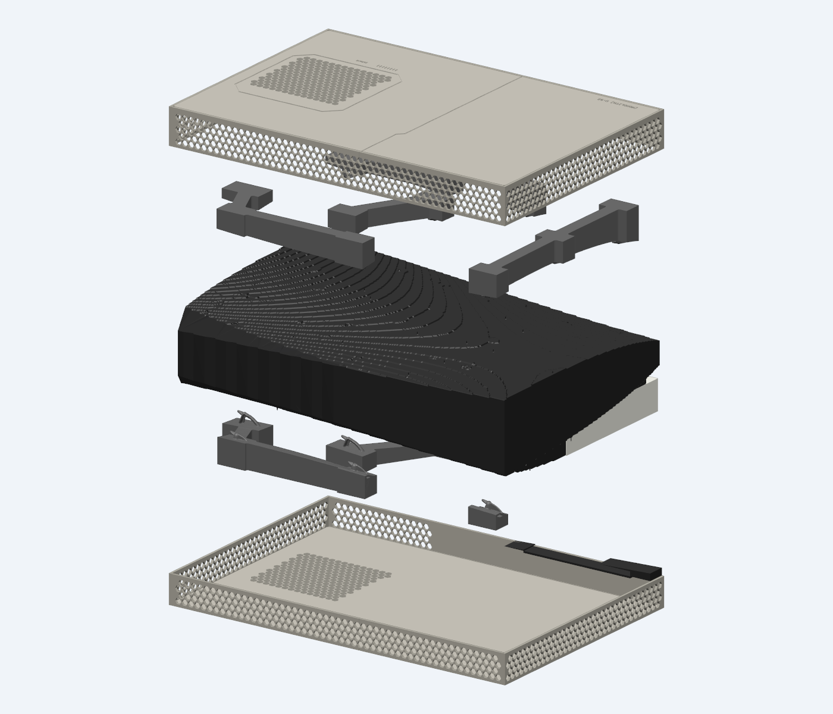
docs/mockups/explode/explode_overall.png
