kelevrablondie/3DPrinting_CADs_visual-ps5-slab/docs/mockups/explode/explode_strip.png

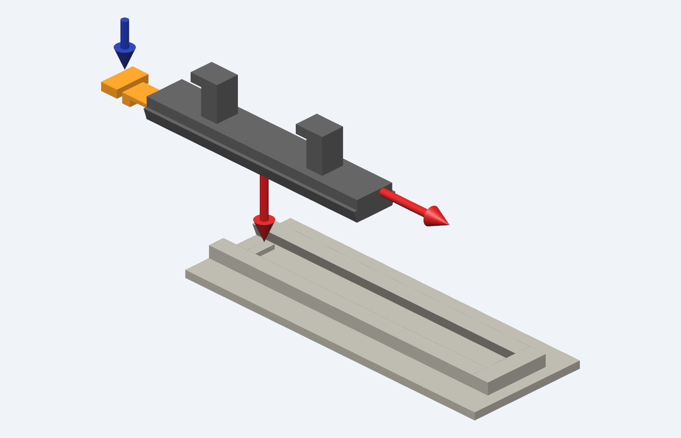
docs/mockups/explode/explode_strip.png
