kelevrablondie/3DPrinting_CADs_visual-ps5-slab/sources/reference-images/teardown_ifixit.jpg

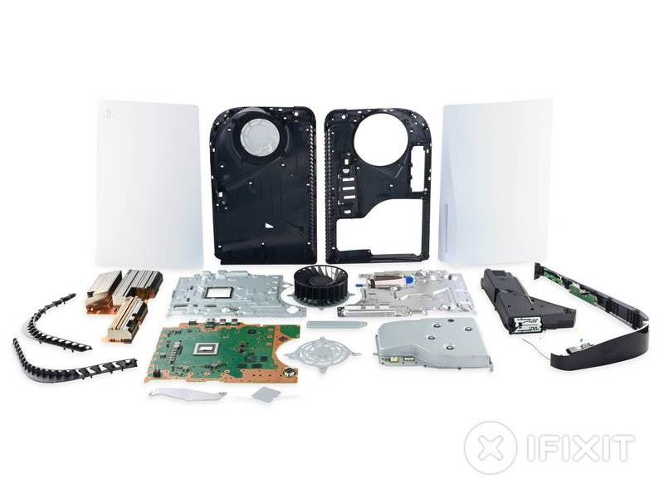
sources/reference-images/teardown_ifixit.jpg
