kelevrablondie/3DPrinting_CADs_visual-ps5-slab/sources/reference-images/xray_creative_electron_ifixit.jpg

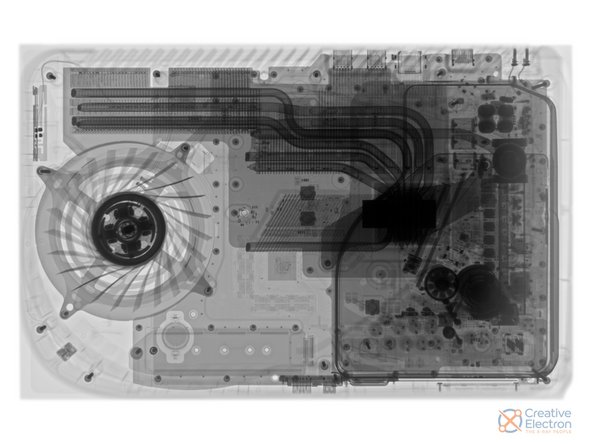
sources/reference-images/xray_creative_electron_ifixit.jpg
