kelevrablondie/3DPrinting_CADs_visual-ps5-slab/sources/reference-images/xray_fan_fit_overlay.png

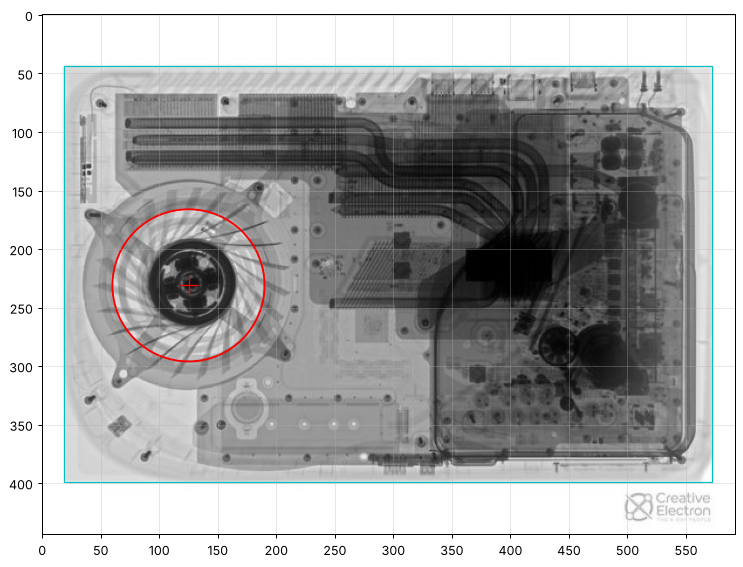
sources/reference-images/xray_fan_fit_overlay.png
