kelevrablondie/3DPrinting_CADs_visual-ps5-slab/analysis/shelf_flat_right_low.stl

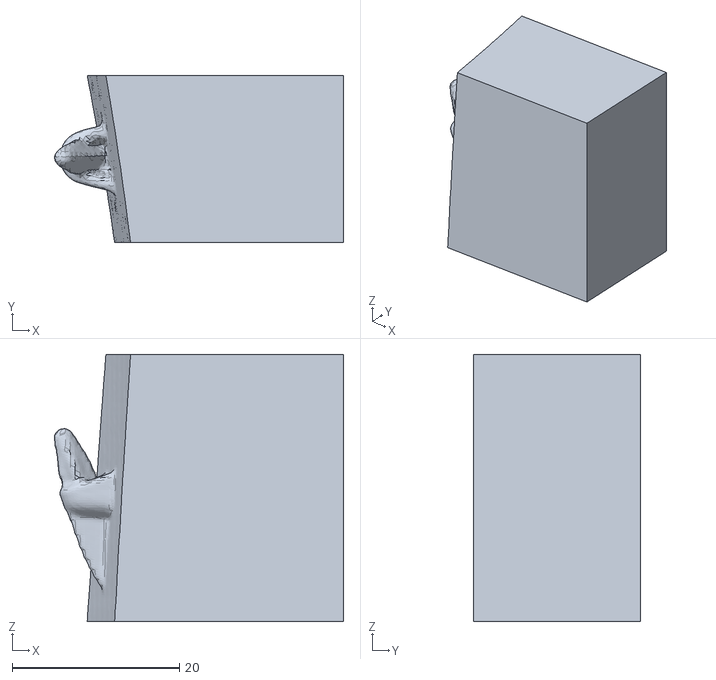
[picture p48: CAD file, 2026-11-02]
analysis/shelf_flat_right_low.stl
34.6 x 20.0 x 32.0
