kelevrablondie/3DPrinting_CADs_visual-ps5-slab/cad/core/shelf_disk_right_c.stl

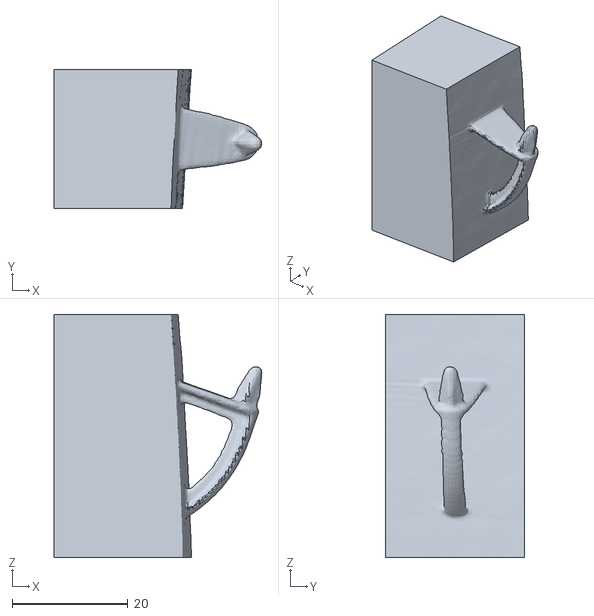
[picture p49: CAD file, 2026-11-02]
cad/core/shelf_disk_right_c.stl
35.9 x 24.0 x 42.0
