kelevrablondie/3DPrinting_CADs_visual-ps5-slab/deliverables/coupon_F11_small_corner.stl

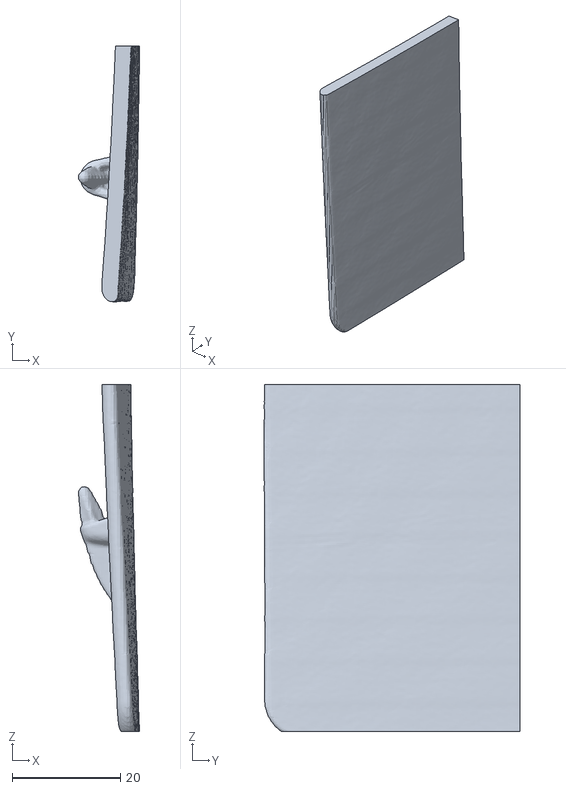
[picture p50: CAD file, 2026-11-02]
deliverables/coupon_F11_small_corner.stl
11.3 x 47.3 x 64.0
