kelevrablondie/3DPrinting_CADs_visual-ps5-slab/deliverables/fit_tests/3_fit_strip_offcut.3mf

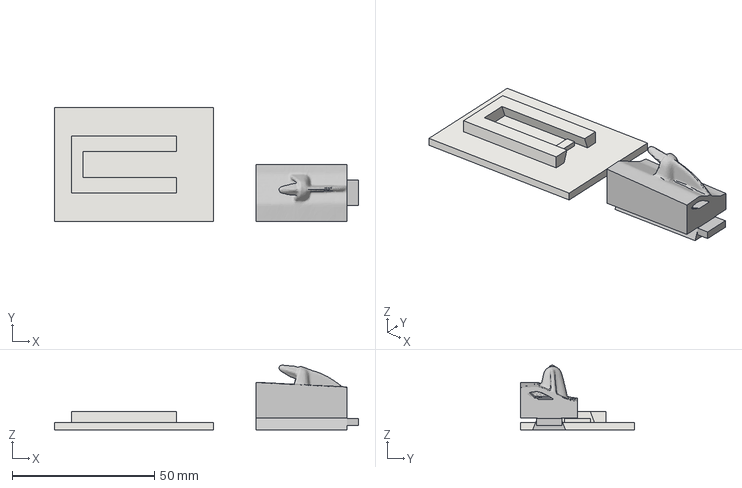
[picture p51: CAD file, 2026-11-10]
deliverables/fit_tests/3_fit_strip_offcut.3mf
107.0 x 40.0 x 22.8 mm
offcut_disk_bottom
clip_strip_disk_bottom
