kelevrablondie/3DPrinting_CADs_visual-ps5-slab/docs/model/monolith_draft.stl

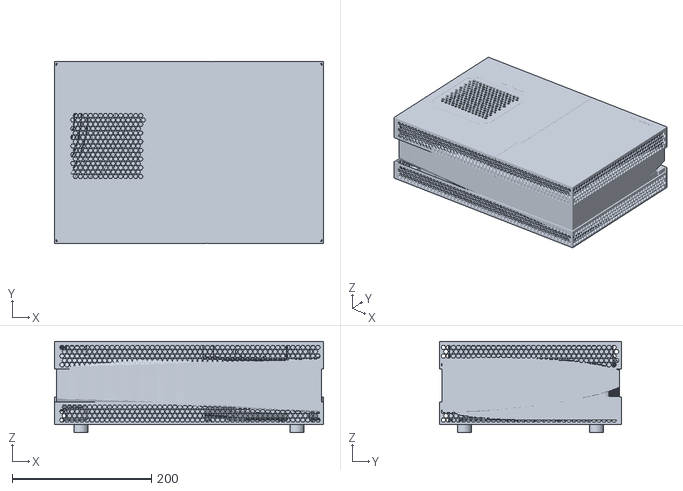
[picture p52: CAD file, 2026-11-10]
docs/model/monolith_draft.stl
386.0 x 261.0 x 131.0
