kelevrablondie/3DPrinting_CADs_visual-ps5-slab/analysis/shelf_disk_left.stl

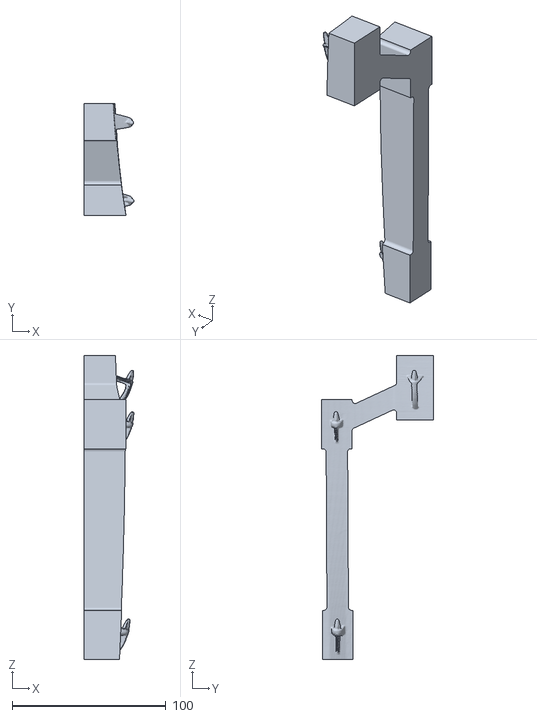
[picture p53: CAD file, 2026-11-02]
analysis/shelf_disk_left.stl
32.5 x 73.0 x 197.7
