kelevrablondie/3DPrinting_CADs_visual-ps5-slab/cad/core/shelf_flat_middle_c.stl

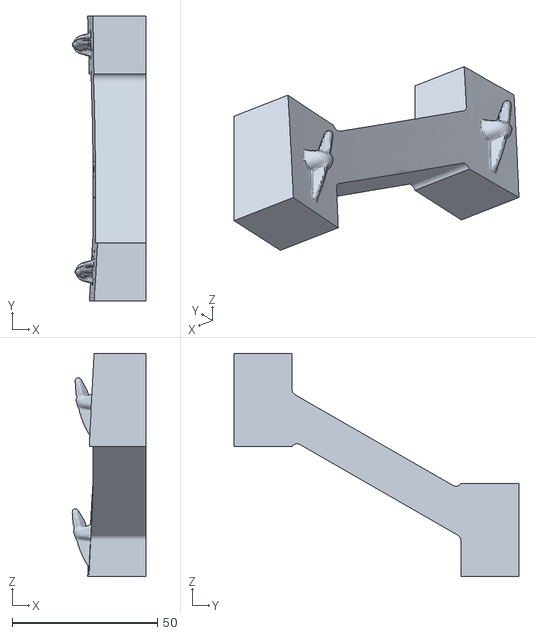
[picture p54: CAD file, 2026-11-02]
cad/core/shelf_flat_middle_c.stl
25.3 x 98.0 x 76.8
