kelevrablondie/3DPrinting_CADs_visual-ps5-slab/deliverables/coupon_F5_large_spring.stl

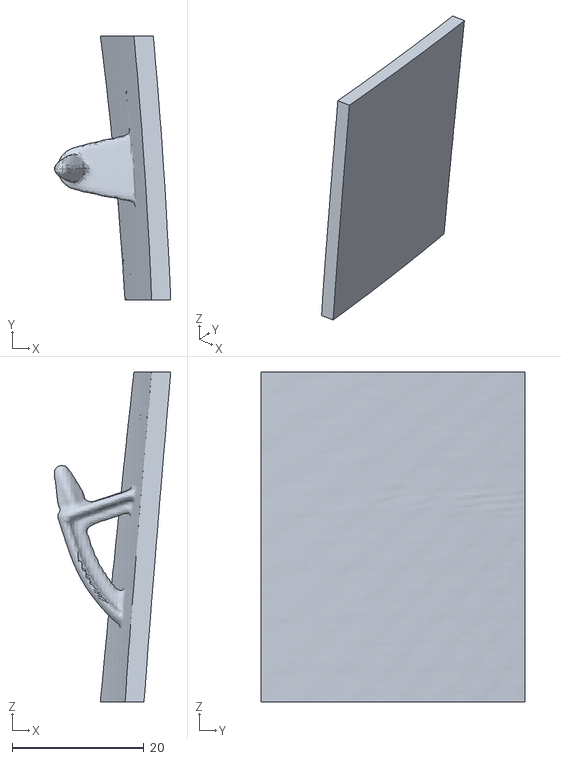
[picture p55: CAD file, 2026-11-02]
deliverables/coupon_F5_large_spring.stl
17.6 x 40.0 x 50.0
