kelevrablondie/3DPrinting_CADs_visual-ps5-slab/analysis/shelf_disk_bottom.stl

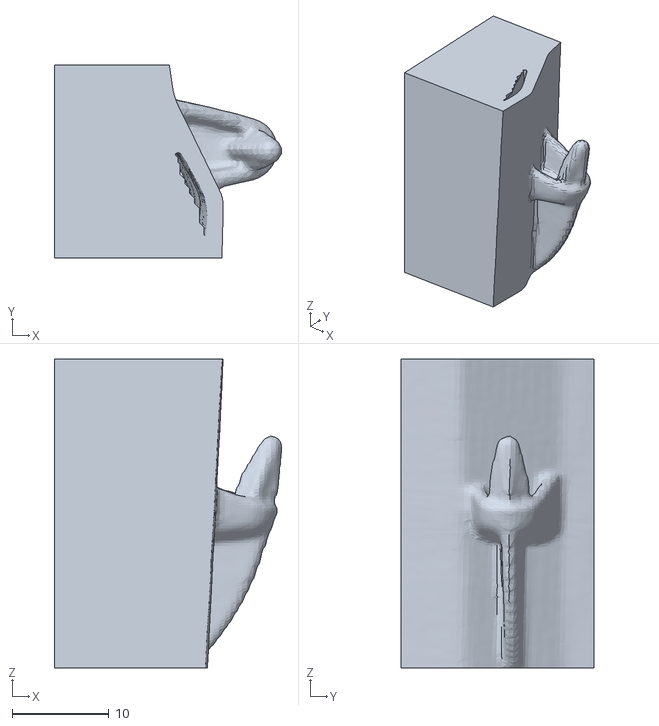
[picture p56: CAD file, 2026-11-02]
analysis/shelf_disk_bottom.stl
23.5 x 20.0 x 32.0
