kelevrablondie/3DPrinting_CADs_visual-ps5-slab/sources/rhys34512-printables-973426/support-for-flat-panel-manually-place-in-model.stl

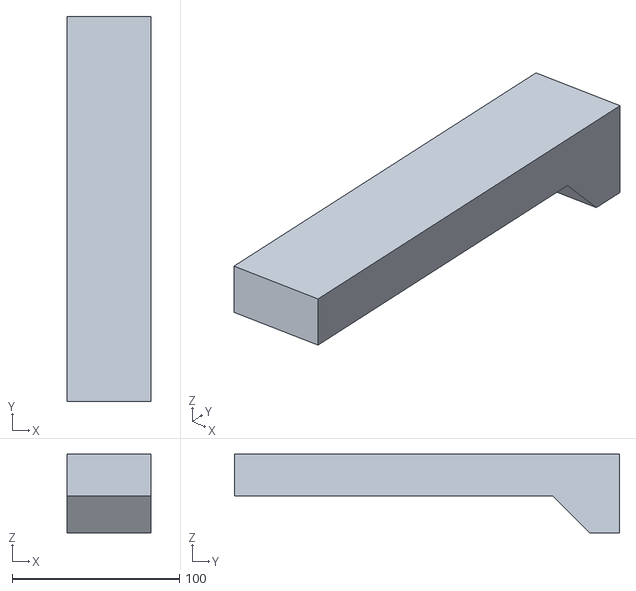
[picture p57: CAD file, 2026-11-02]
sources/rhys34512-printables-973426/support-for-flat-panel-manually-place-in-model.stl
50.0 x 230.0 x 47.0
