kelevrablondie/3DPrinting_CADs_visual-ps5-slab/analysis/shelf_flat_left.stl

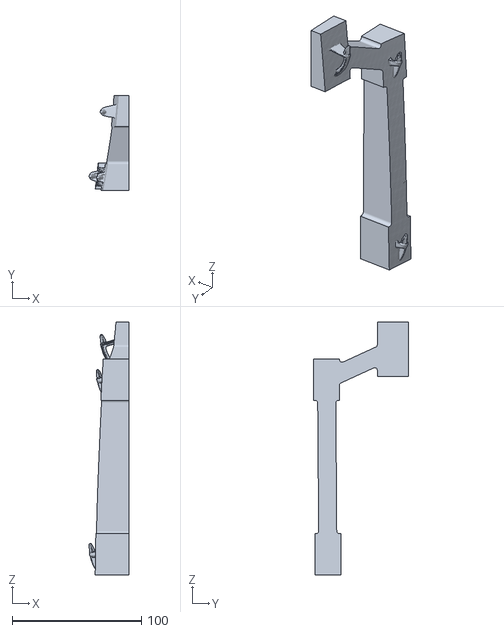
[picture p58: CAD file, 2026-11-02]
analysis/shelf_flat_left.stl
31.0 x 73.2 x 195.5
