kelevrablondie/3DPrinting_CADs_visual-ps5-slab/cad/core/shelf_flat_bottom_c.stl

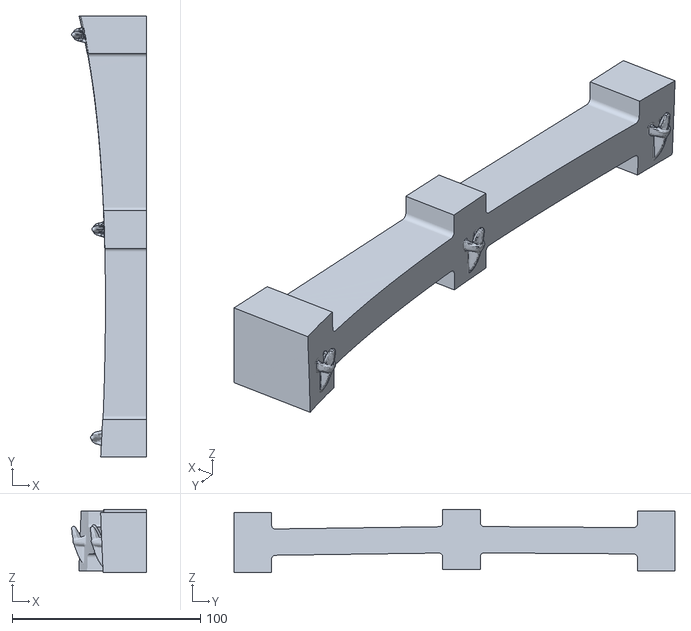
[picture p59: CAD file, 2026-11-02]
cad/core/shelf_flat_bottom_c.stl
39.8 x 234.5 x 33.5
