kelevrablondie/3DPrinting_CADs_visual-ps5-slab/cad/core/shelf_disk_middle_c.stl

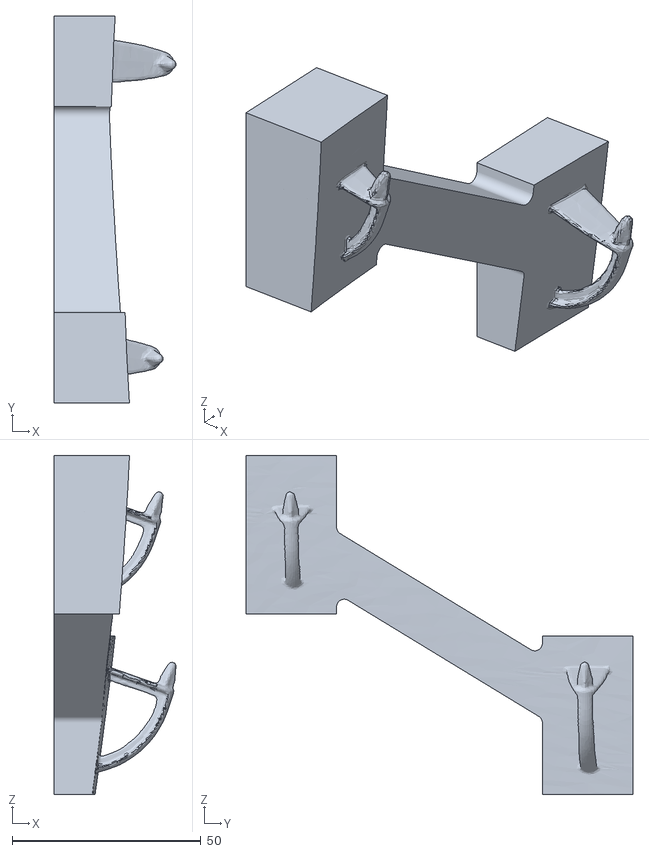
[picture p60: CAD file, 2026-11-02]
cad/core/shelf_disk_middle_c.stl
32.3 x 102.5 x 89.8
