kelevrablondie/3DPrinting_CADs_visual-ps5-slab/cad/core/shelf_flat_right_c.stl

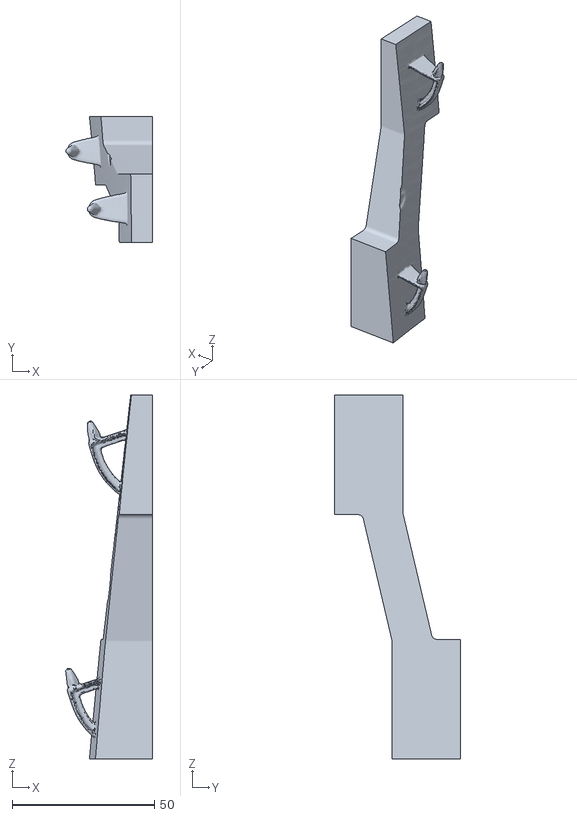
[picture p61: CAD file, 2026-11-02]
cad/core/shelf_flat_right_c.stl
30.4 x 44.2 x 127.8
