kelevrablondie/3DPrinting_CADs_visual-ps5-slab/analysis/core_proxy.stl

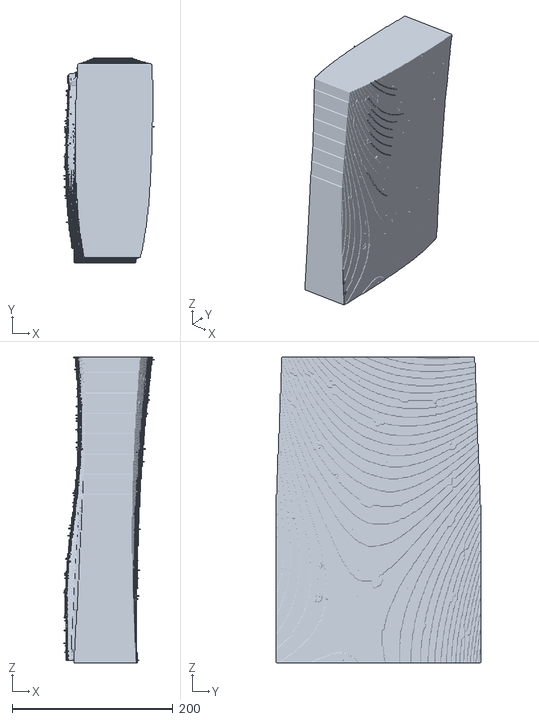
[picture p62: CAD file, 2026-11-02]
analysis/core_proxy.stl
113.0 x 255.0 x 381.0
