kelevrablondie/3DPrinting_CADs_visual-ps5-slab/cad/core/core_final.stl

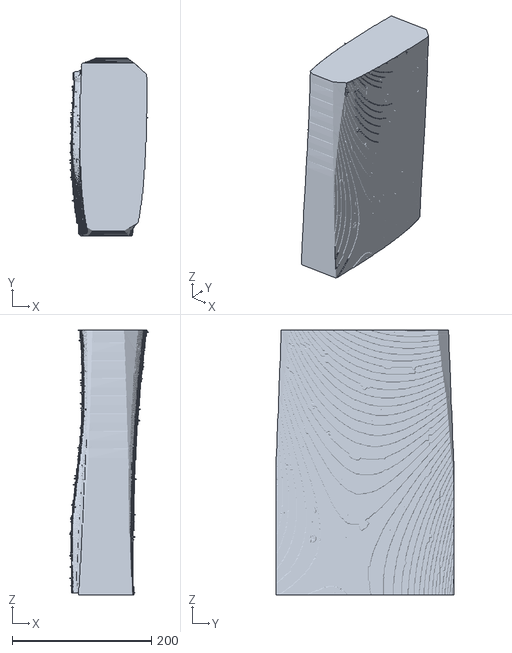
[picture p63: CAD file, 2026-11-02]
cad/core/core_final.stl
112.9 x 254.8 x 380.1
