kelevrablondie/3DPrinting_CADs_visual-ps5-slab/analysis/obj_plates.stl

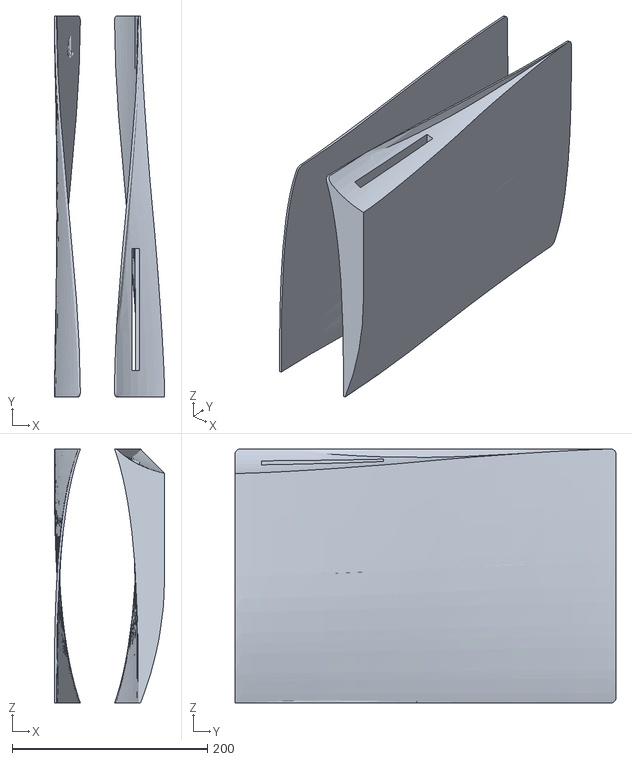
[picture p64: CAD file, 2026-11-02]
analysis/obj_plates.stl
112.9 x 390.0 x 260.0
