kelevrablondie/3DPrinting_CADs_visual-ps5-slab/cad/core/drive_proxy.stl

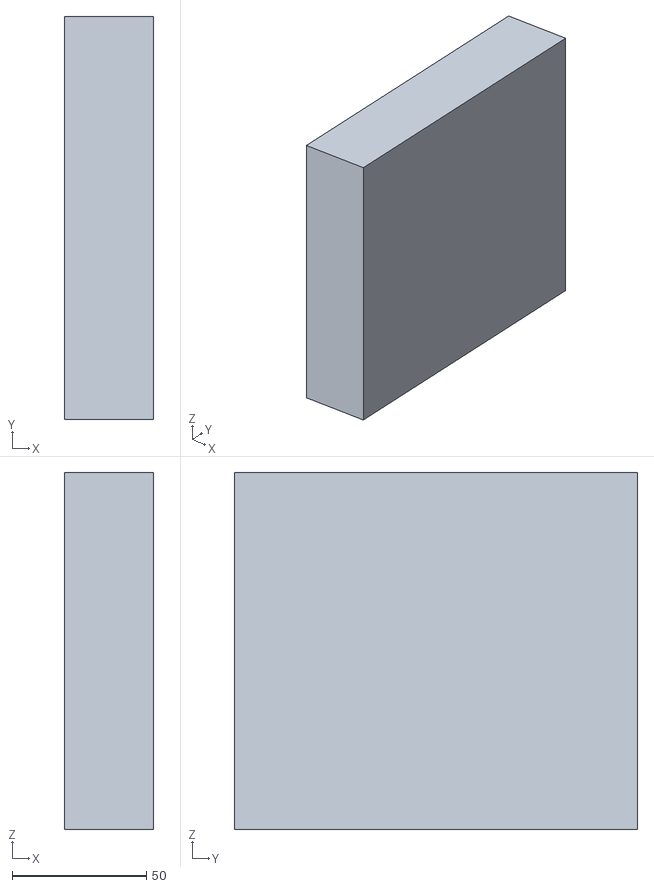
[picture p65: CAD file, 2026-11-02]
cad/core/drive_proxy.stl
33.0 x 150.0 x 133.0
