kelevrablondie/3DPrinting_CADs_visual-ps5-slab/analysis/obj_front_glass.stl

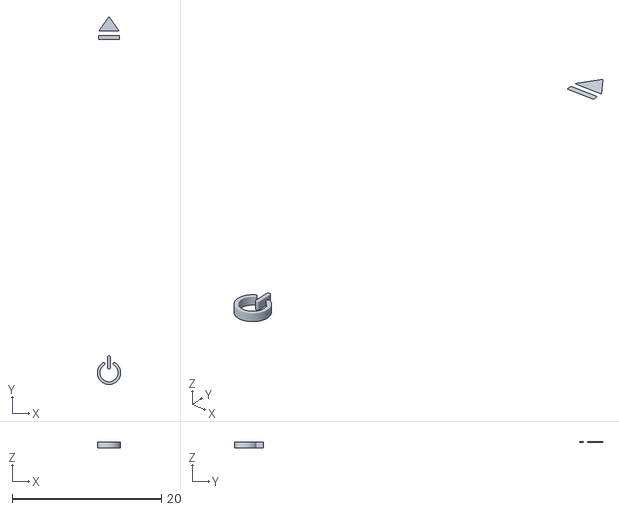
[picture p66: CAD file, 2026-11-02]
analysis/obj_front_glass.stl
3.15 x 49.4 x 0.856
