kelevrablondie/3DPrinting_CADs_visual-ps5-slab/analysis/obj_lightbar.stl

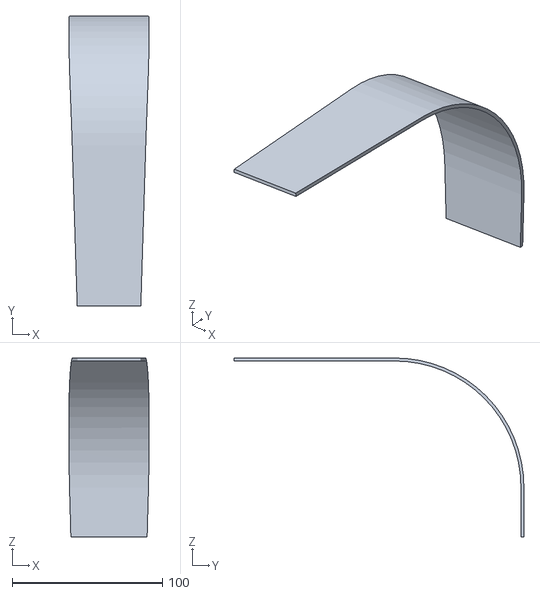
[picture p67: CAD file, 2026-11-02]
analysis/obj_lightbar.stl
53.5 x 192.7 x 119.0
