kelevrablondie/3DPrinting_CADs_visual-ps5-slab/analysis/obj_buttons.stl

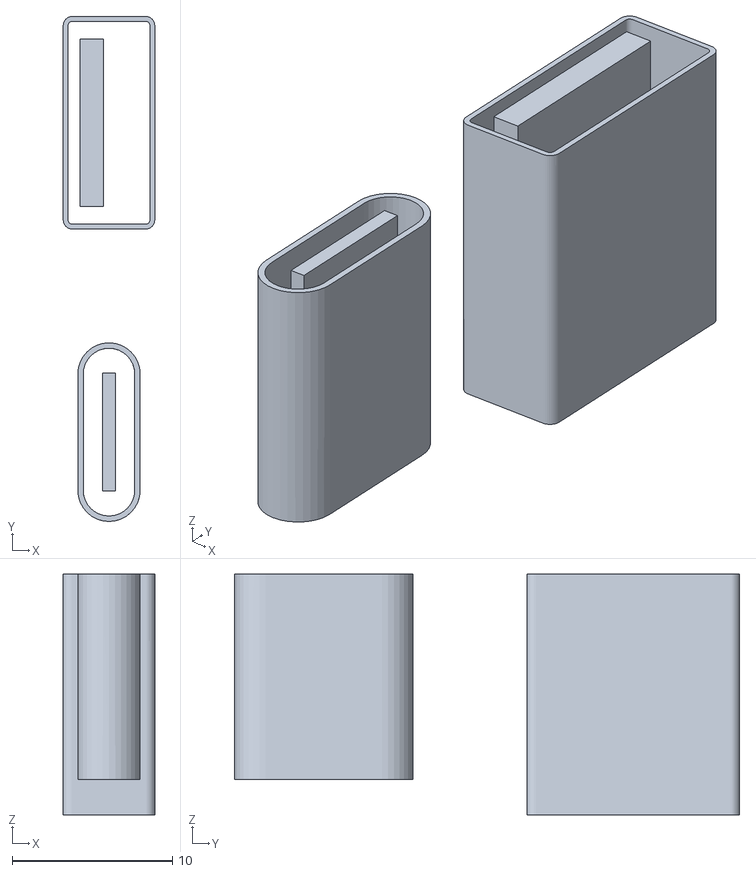
[picture p68: CAD file, 2026-11-02]
analysis/obj_buttons.stl
5.71 x 31.5 x 15.0
