kelevrablondie/3DPrinting_CADs_visual-ps5-slab/analysis/obj_core.stl

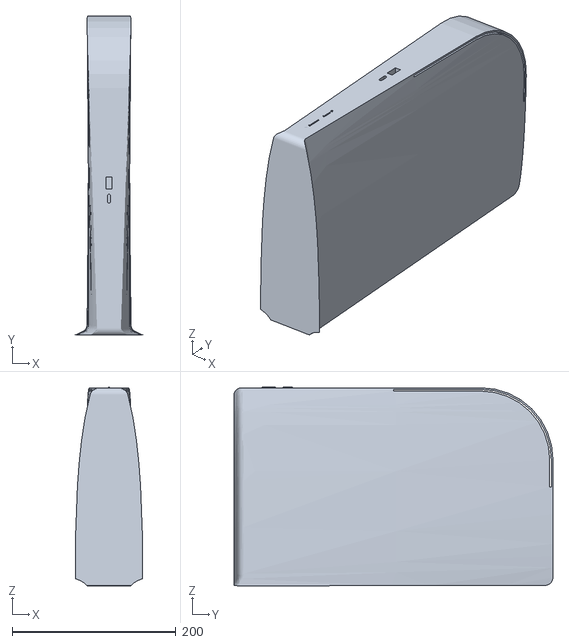
[picture p69: CAD file, 2026-11-02]
analysis/obj_core.stl
82.3 x 390.0 x 242.9
