kelevrablondie/3DPrinting_CADs_visual-ps5-slab/analysis/obj_core_matte.stl

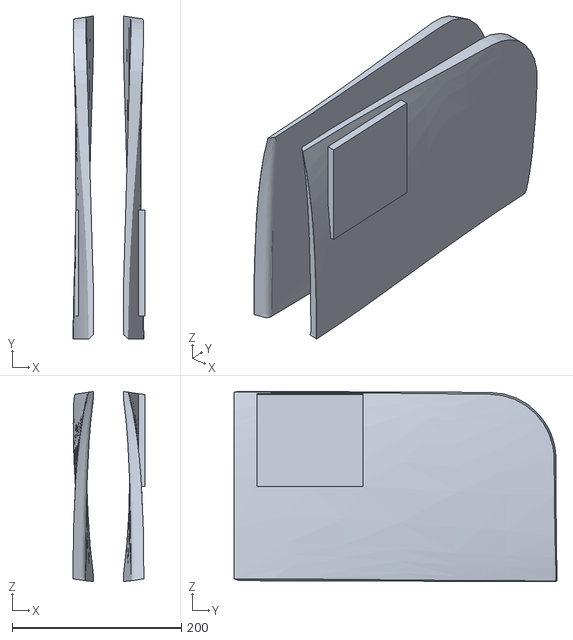
[picture p70: CAD file, 2026-11-02]
analysis/obj_core_matte.stl
85.1 x 381.3 x 224.4
