kelevrablondie/3DPrinting_CADs_visual-ps5-slab/(list of files, cad)

Other CAD files:
sources/rhys34512-printables-973426/flat-panel-side.stl
deliverables/fit_tests/2_coupon_F5_large_spring.3mf
sources/rhys34512-printables-973426/disk-panel.stl
cad/core/shelf_disk_bottom_c.stl
deliverables/fit_tests/1_coupon_F11_small_corner.3mf
analysis/shelf_disk_right.stl
cad/core/shelf_flat_right_low_c.stl
analysis/shelf_flat_middle.stl
analysis/shelf_disk_middle.stl
analysis/shelf_flat_bottom.stl
cad/core/shelf_flat_left_c.stl
analysis/shelf_flat_right.stl
cad/core/shelf_disk_left_c.stl
