kelevrablondie/3DPrinting_CADs_visual-ps5-slab/sources/reference-images/measure_front_drive.jpg

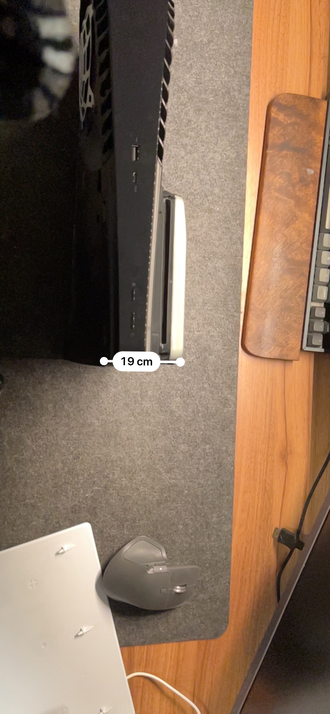
sources/reference-images/measure_front_drive.jpg
