kelevrablondie/3DPrinting_CADs_visual-ps5-slab/sources/reference-images/measure_rear_face.jpg

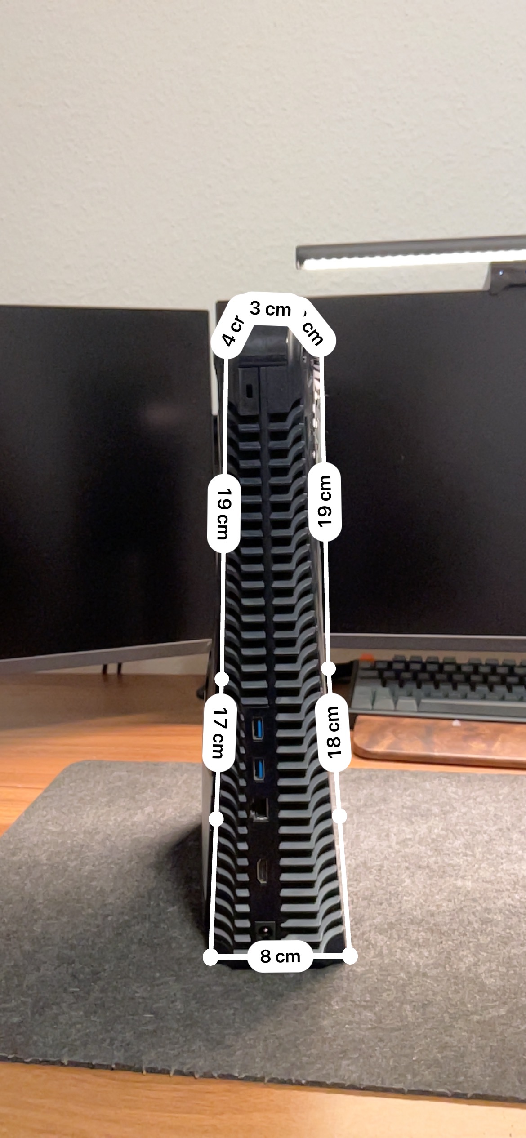
sources/reference-images/measure_rear_face.jpg
