kelevrablondie/3DPrinting_CADs_visual-ps5-slab/sources/reference-images/measure_side_fan_face.jpg

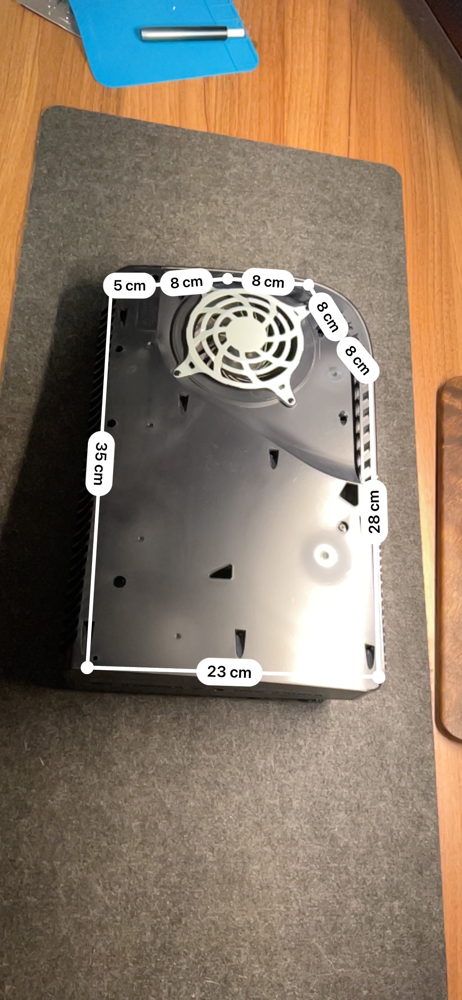
sources/reference-images/measure_side_fan_face.jpg
