kelevrablondie/3DPrinting_CADs_visual-ps5-slab/(commit log)

2026-11-02 Snapshot PS5 slab project before further changes
    [core_final.stl, core_proxy.stl, coupon_F11_small_corner.stl, coupon_F5_large_spring.stl, disk-panel.stl, drive_proxy.stl, flat-panel-side.stl, obj_buttons.stl]
2026-11-02 Add plain-language to-do list for no-print tasks
2026-11-02 Switch project license from MIT to CC BY-NC 4.0
    The clip shelves and coupons derive from a CC BY-NC 4.0 scan, which MIT cannot cover. Third-party files in sources/ keep their own terms.
2026-11-02 Apply plate decisions: 255 mm depth, single seam, shelves v2, Ø110 grille
    Split the flat right shelf so a seam at z~158 clears every shelf, add the 0.8 mm pocket depth to the shelf glue faces, and use 3.4 mm grille holes to keep the open area within 2%. Replace the v1 zip, whose README told people to glue on the console. Disc side down is chosen for the APU's liquid metal. Glue-plane spacing stays at 114 mm until TODO Job 1B is measured.
    [shelf_disk_bottom.stl, shelf_disk_bottom_c.stl, shelf_disk_left.stl, shelf_disk_left_c.stl, shelf_disk_middle.stl, shelf_disk_middle_c.stl, shelf_disk_right.stl, shelf_disk_right_c.stl]
2026-11-02 Add plate slide measurement and note MakerWorld source
    Closed plate ends need the slide distance. The cross-check STLs carry MakerWorld model 2863474 in their headers.
2026-11-02 Adopt BoxPlates ideas: vented end walls, slide-in clips, stepped seam
    Record Mike's decisions after the devynPC video review: ends become
    vented plate walls (option D), clips slide into channels instead of
    being glued, and the tile seam is diagonal and stepped. The heat test
    is optional. Also commit the rejected semi-open end-wall code and
    mockups for reference until the redesign replaces them.
2026-11-02 Add notes from devynPC's first PS5 Pro plate video
2026-11-02 Add partial test print with spirit-level check to TODO
2026-11-02 Add wrap-around plate mockup with level lips and constant stripe
2026-11-02 Put the drive behind the level south lip with a disc slot hole
2026-11-02 Take disc slot size and position from the stock plate scan
2026-11-02 Use 6 mm hex honeycomb on back lips for exhaust airflow
2026-11-02 Engrave north top: faceted seam line, chamfered fan panel, MONOLITH markings
2026-11-02 Embed technical mockup and interactive STL draft in README
    [monolith_draft.stl]
2026-11-09 Add reverse-engineering notes and X-ray I/O overlay
    Side note on whether TODO Jobs 1B/1C/1D can be closed from files:
    - STEP/SLDPRT (pre-launch, wrong proportions), DWG (stylised 2D block)
    and the resin miniature (stylised plates) are not dimensional; kept local.
    - Rear/front port positions along the length from the iFixit X-ray (+-4 mm),
    cross-checked against the disc slot from the plate scan.
    - Rear port column vs the 40 mm stripe; plug heads need notches.
    - Job 1B: Sony's 104 mm spec favours S = 114; Job 1C not derivable.
    Measurement files (CLAUDE.md, TODO.md, HANDOFF.md) are untouched.
    Claude-Session: https://claude.ai/code/se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
2026-11-09 Add web research report on PS5 width, I/O and slide distance
    Side note next to the reverse-engineering doc (measurement files untouched):
    - Job 1B: real tape readings (~103-104 mm widest) plus 95 mm at the drive
    end support S = 114 mm; S = 106 contradicts every source.
    - Job 1D: no dimensioned source; only port order confirmed.
    - Job 1C: no measured slide distance anywhere; method to measure it.
    Claude-Session: https://claude.ai/code/session_01XtGrGWZF9HxXHs2MLaCa2i
2026-11-10 Notchless stripe, disc-slot filler, sleeve decision, exploded-view sketch
    - Research notes applied: S=114 adopted as working spacing, X-ray port
    positions recorded; TODO jobs 1B/1D cut to one reading each.
    - Black stripe widened on the disc side (x -25.5..22.2) so rear plugs fit
    without notches and the disc slot sits inside the stripe; new black
    filler at the front drive end doubles as the disc guide.
    - Decided (not built): plates overhang both ends by the slide distance so
    removal stays OEM; Job 1C is needed again.
    - Throwaway exploded-view sketch of the clip-strip proposal for review.
    [monolith_draft.stl]
2026-11-10 Clip strips, squared south face lip, fit tests, changelog
    - South face lip covers the core to its narrowest face edge: one 40 mm black
    band, disc slot through the lip, hidden guide printed with it, square corners.
    - Slide-in clip strips: dovetail rails, end stop and latch ledge on the plate
    floor; hooks keep their scanned positions. check_clip_strips.py verifies them.
    - Fit tests to print first (deliverables/fit_tests, Bambu Studio-ready 3MF).
    - Declined designs moved to archive/. CHANGELOG.md added.
    [1_coupon_F11_small_corner.3mf, 2_coupon_F5_large_spring.3mf, 3_fit_strip_offcut.3mf, monolith_draft.stl]
2026-11-10 Bring handoff and 2D mockup in line with the build
    HANDOFF.md now opens with the 2026-11-10 state (clip strips built, fit tests,
    open items) and marks the 2026-11-02 sections as history. wrap_views.png
    redrawn: 40 mm face stripe, disc slot through the south lip.
2026-11-10 Re-export interactive 3D and face render from the final build
    The README STL came from the first clip-strip build, before the pocket trim
    and the overlap fix. Rebuilt wrap_horizontal and exported again.
    [monolith_draft.stl]
